msw-winterthur/uC_Board/README.md

# [uC_Board Wiki](https://github.com/msw-winterthur/uC_Board/wiki)

Du brauchst [Hilfe](https://github.com/msw-winterthur/uC_Board/wiki) oder weisst nicht [wo Anfangen](https://github.com/msw-winterthur/uC_Board/wiki)? Besuche unbedingt das [Wiki](https://github.com/msw-winterthur/uC_Board/wiki)!
