msw-winterthur/uC_Board/Dokumente/Herstellung/Eagle Fusion Tipps und Tricks.docx

- MOVE Teilenummer (MOVE R10 oder move r10)
- Gruppe in Schema Markieren → Wird auch auf Board markiert → Ganze Gruppe zusammen verschieben
- Am Raster Ausrichten: Ändern-Untermenü öffnen → Ausrichten wählen → Fadenkreuzsymbol wählen
