msw-winterthur/uC_Board/Dokumente/Herstellung/Layout-Hinweise.pdf

## uC-Board

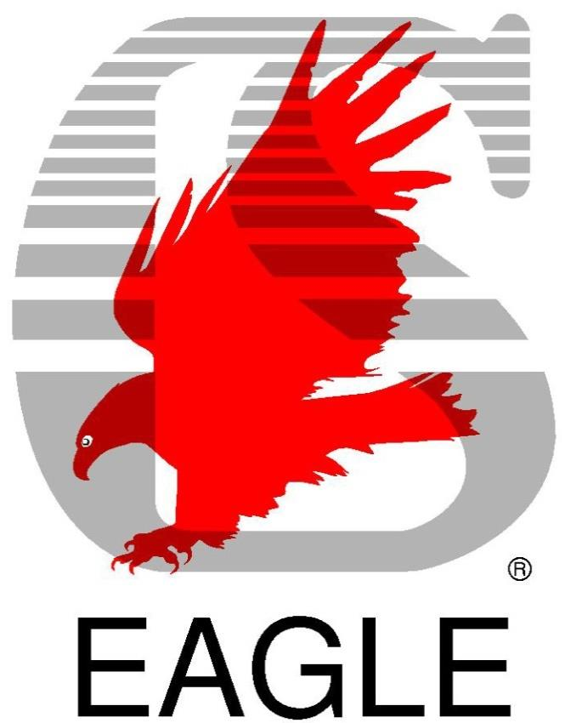
[picture p1: figure]
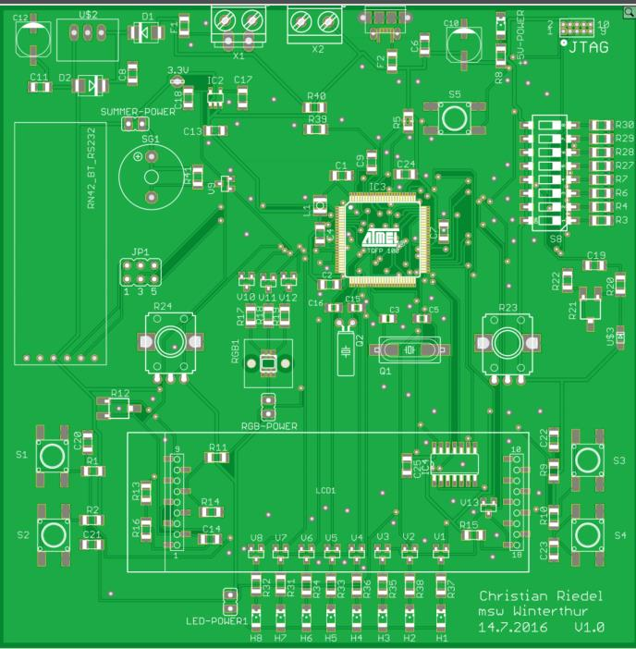
[picture p2: figure]

Layout-Hinweise.docx | Riedel/Trüb | Seite 1

# Layout-Hinweise zum uC-Board

### Inhaltsverzeichnis

### 1. Netzklassen

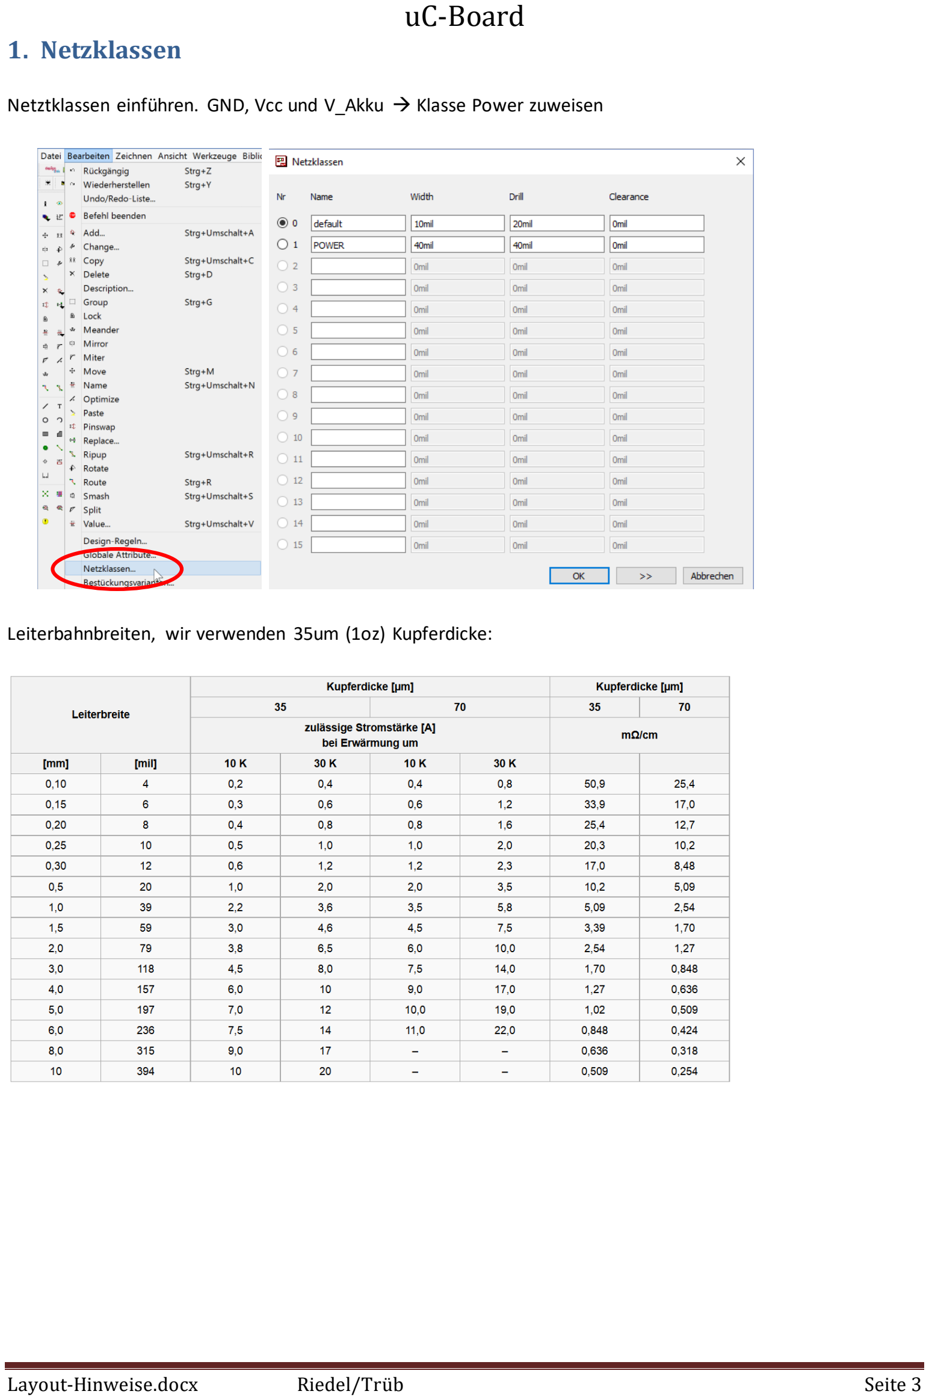
[picture p3: page 3]

Netztklassen einführen. GND, Vcc und V_Akku → Klasse Power zuweisen

Leiterbahnbreiten, wir verwenden 35um (1oz) Kupferdicke:

### 2. Raster

Für ein präzises Platzieren lohnt es sich, ein feines Raster einzustellen.

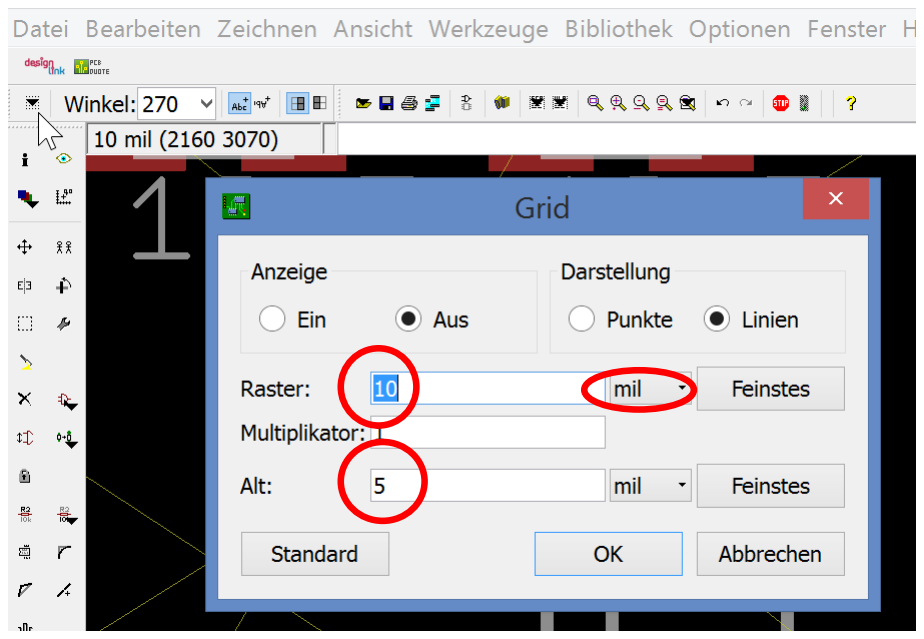
[picture p4: figure]

### 3. Design Rules

DRC Einstellungen vornehmen:

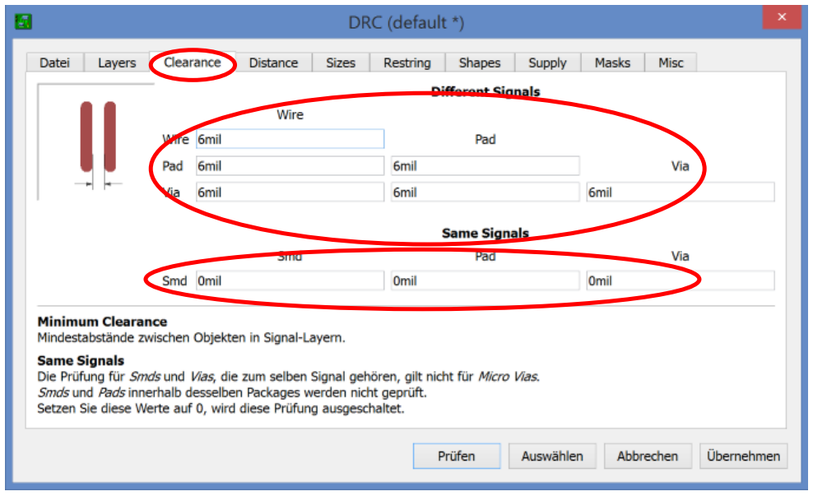
[picture p5: figure]
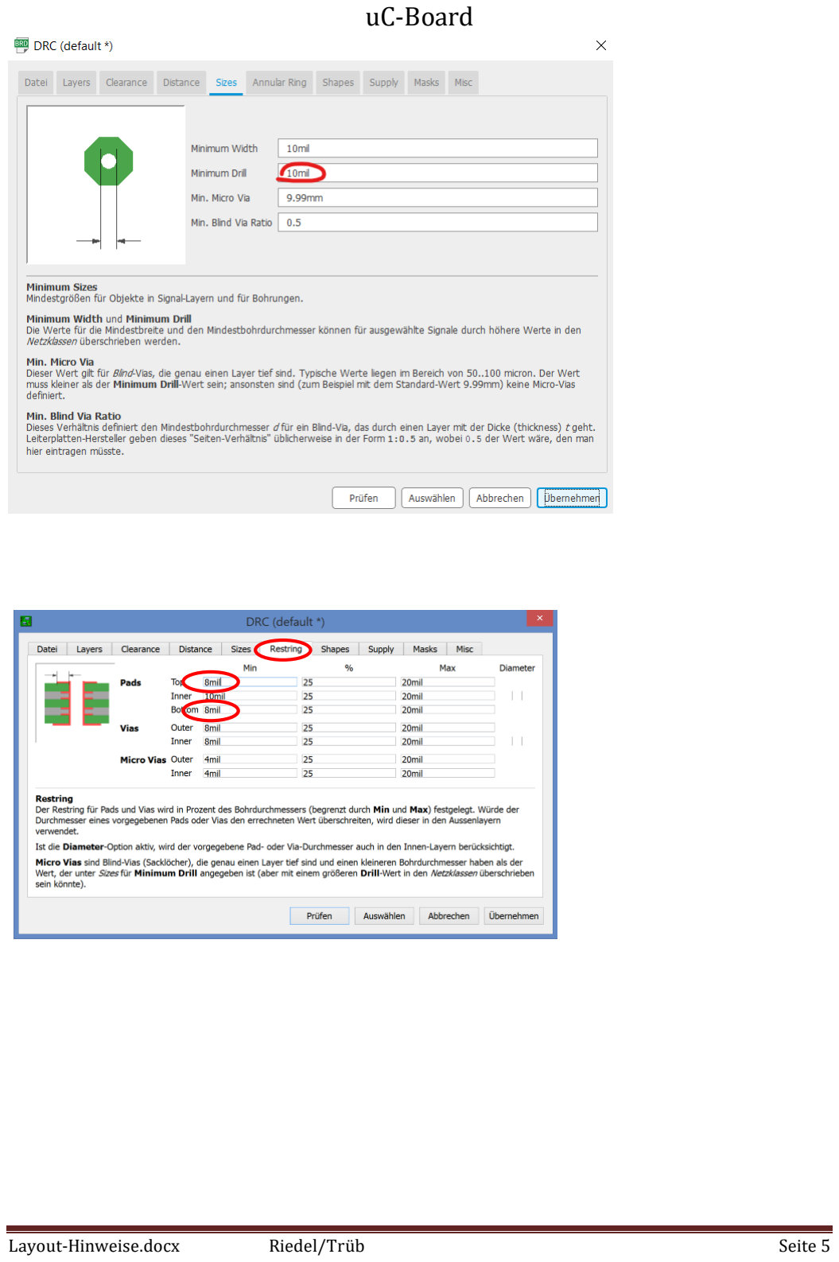
[picture p6: page 5]

### 4. Gruppieren

Platziere die Bauteile, so dass die Luftlinien möglichst optimal, also kurz sind.

Bauteile die im Schema zusammen gehören, sollten auch beim Platzieren nahe zusammen bleiben. Beispiele:
- Gruppe Quarz und Kondensatoren
- 8xLED Port mit FET, R und LED
- 5V Spannungsversorgung mit Spannungsregker, C, R, Sicheerung und Dioden

Auf dem Board:

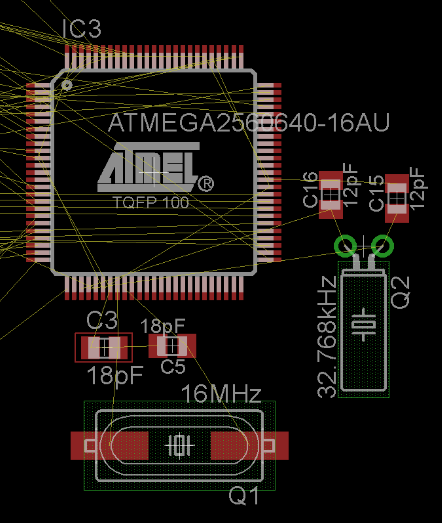
[picture p7: figure]

Quarz und Kondensatoren

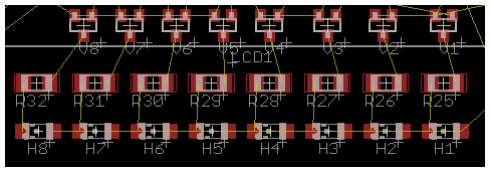
[picture p8: figure]

LED Port mit FET, R und LED

### 5. Stecker platzieren auf dem Board

ACHTUNG: | Phoenix Stecker | USB-C Stecker

Beide Stecker müssen über den Printrand hinaus platziert werden! Siehe Muster Prints BT_CAR_21.

JTAG-Stecker nahe am Rand platzieren und Pin1 links, damit sich Flachbandkabel gut einstecken lässt.

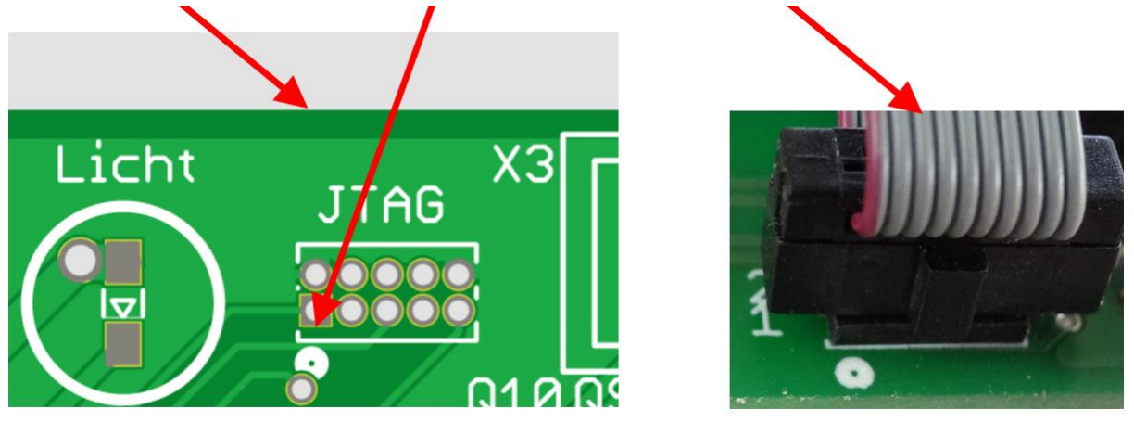
[picture p9: figure]

### 6. Bohrungen

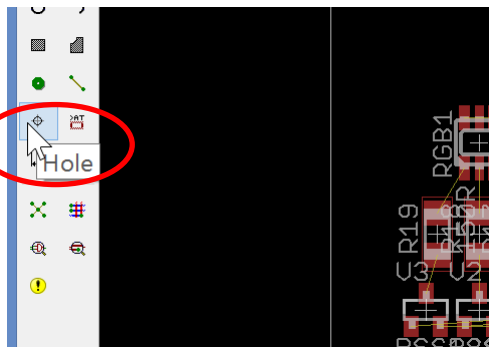
[picture p10: figure]
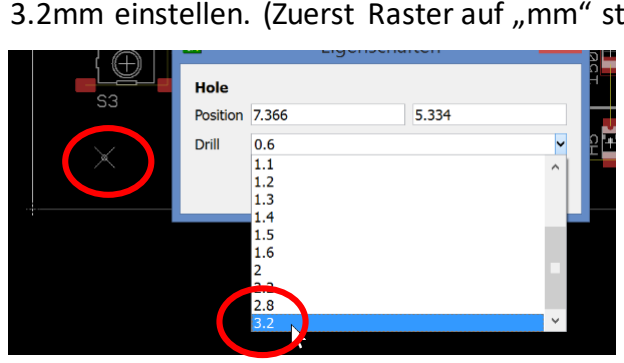
[picture p11: figure]

Bohrungen:
Befestigungslöcher platzieren Via „Info“ die Eigenschaft der Bohrung auf z.B. 3.2mm einstellen. (Zuerst Raster auf „mm“ stellen).

### 7. Autorouter

Nach dem Platzieren der Gruppen kann mit dem Autorouter überprüft werden, ob das Layouten möglich sein wird. Es sollten Werte von 95% oder grösser erreicht werden…

Mit der Einstellung Routing Grid wird eingestellt, wie fein der Autorouter arbeiten soll.

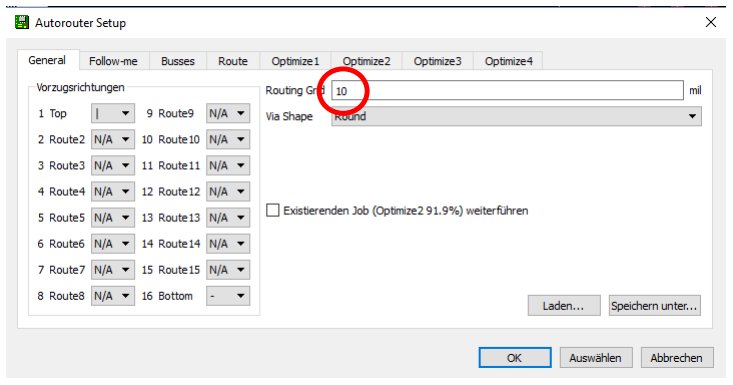
[picture p12: figure]

Je kleiner der Wert desto eher schafft er alles zu routen, braucht aber auch mehr Rechenzeit.

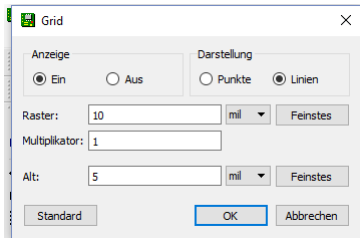
[picture p13: figure]
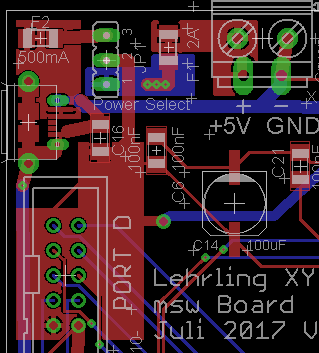
[picture p14: figure]

Zuerst die „dicken“ (mind. 30mil) VCC und GND Linien zu den Steckern ziehen. Eventuell Polygon zu Hilfe nehmen.
erst dann mit den dünnen Linien starten!

Raster beim selber Routen auf ein feines Mass einstellen.

Tipp: Auch hier kann mit Ctrl und Bauteil Auswahl das Element in den Raster „springen“.

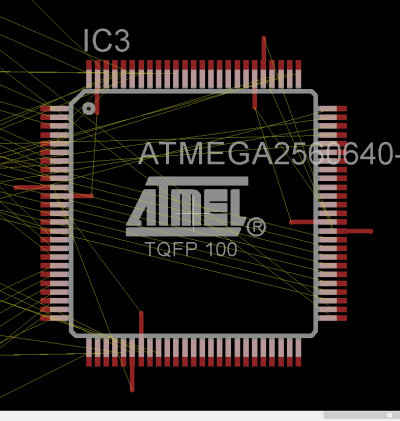
[picture p15: figure]

Vorbereitung Routen: GND, Vcc und Pins am Prozessor vorbereiten GND nach Innen (unter das Gehäuse) und Vcc nach Aussen (vom Gehäuse weg). So können die verschiedenen Netzklassen (unterschiedliche Leiterbahnbreiten), besser am Prozessor angeschlossen werden.

Beim selber Routen 10mil
Leiterbahnbreite einstellen!

Jetzt den Autorouter starten um die Platzierung zu überprüfen. Mit grosser Wahrscheinlichkeit wird 100% nicht erreicht. Autorouterwerte von ca. 95% gelten als guter Platzierungswert. Die Platzierung ist dann ok.

Selbst wenn der Autorouter eine 100% Lösung findet, ist das noch kein optimales Layout! Mehr dazu später.

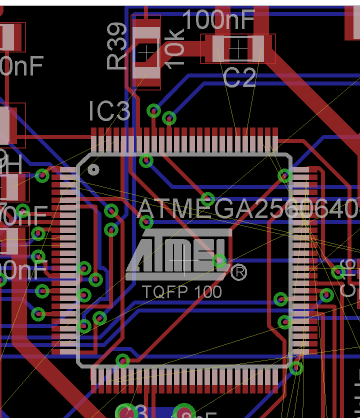
[picture p16: figure]
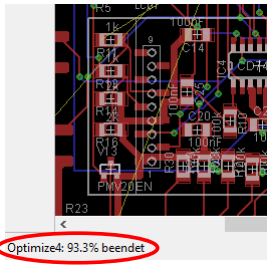
[picture p17: figure]

Gut zu erkennen, dass nicht alle Pins am Prozessor verbunden wurden
Die Verbindungen zu C2 konnten nicht realisiert werden, weil es GND und Vcc (Netzklasse POWER) sind. Diese Leitungen sind mit 40mil zu breit um am Prozessor angeschlossen zu werden. In solchen Fällen hilft das „hinausziehen“ dieser Pins.

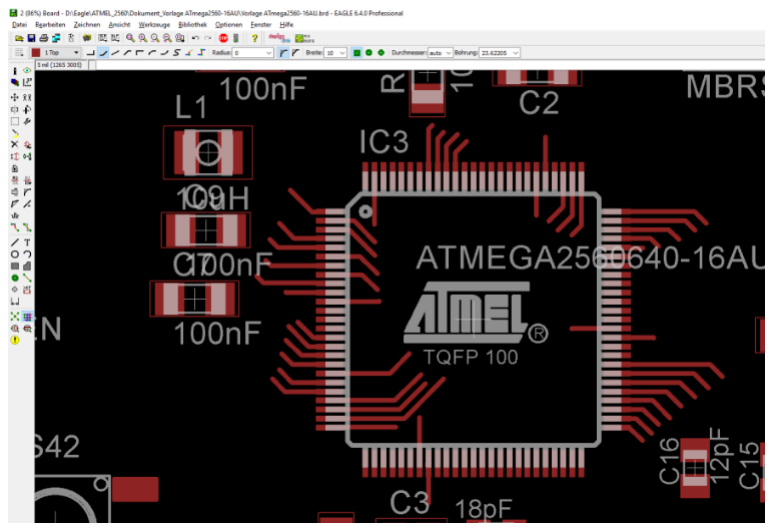
[picture p18: figure]

Mit Ripup Gruppe alle Leiterbahnen wieder löschen. Nun die „schwierigen“ Prozessorpins noch etwas verlängern. So hat der Autorouter mehr Möglichkeiten.

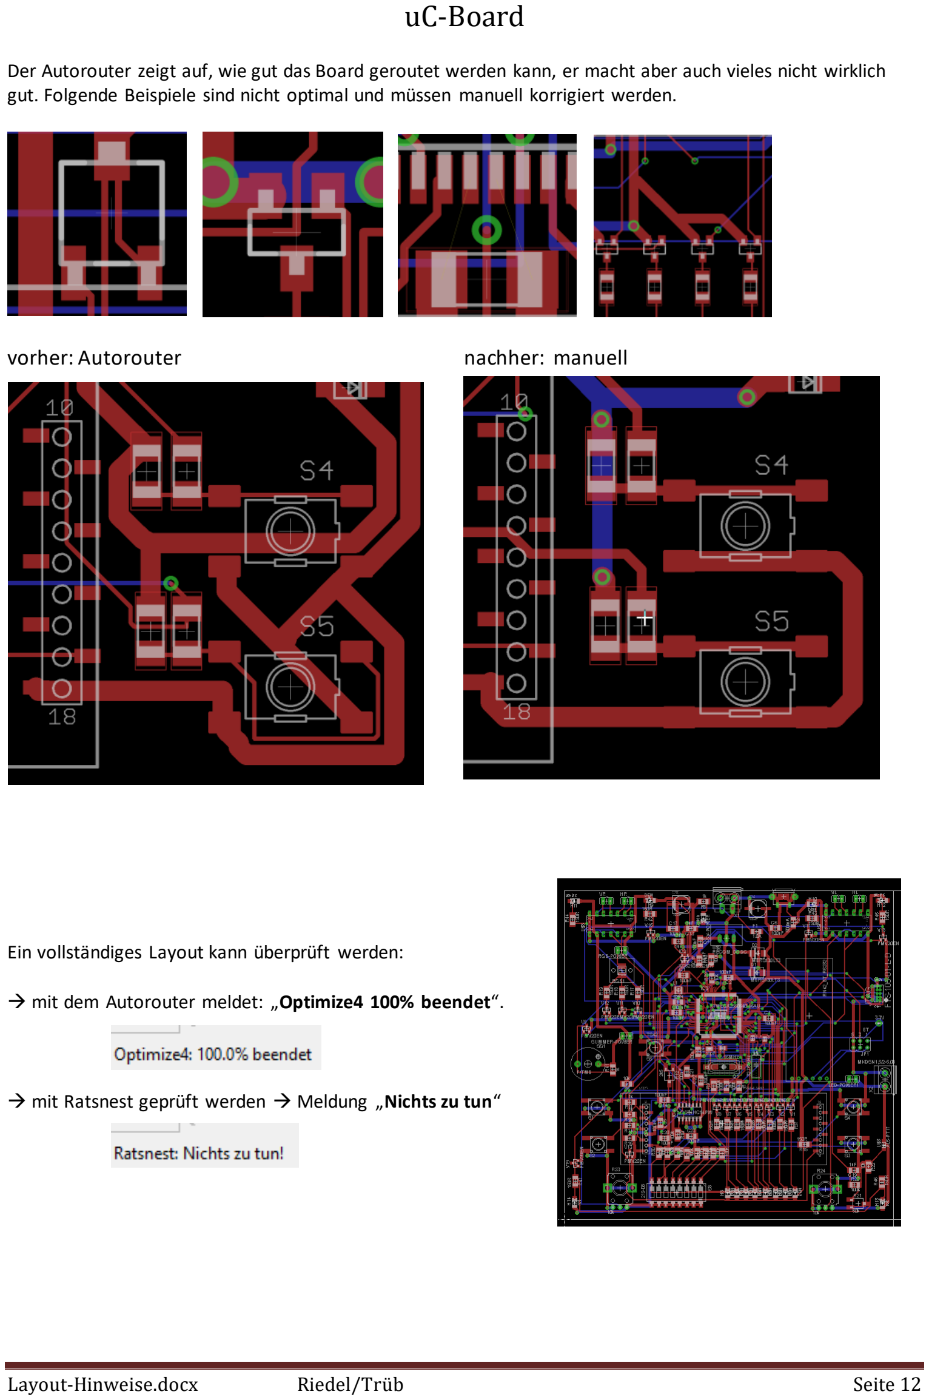
[picture p19: page 12]

Der Autorouter zeigt auf, wie gut das Board geroutet werden kann, er macht aber auch vieles nicht wirklich gut. Folgende Beispiele sind nicht optimal und müssen manuell korrigiert werden.

vorher: Autorouter | nachher: manuell

Ein vollständiges Layout kann überprüft werden:

→ mit dem Autorouter meldet: „Optimize4 100% beendet“.

→ mit Ratsnest geprüft werden → Meldung „Nichts zu tun“

### 8. Polygone

Das sollte jetzt so aussehen:

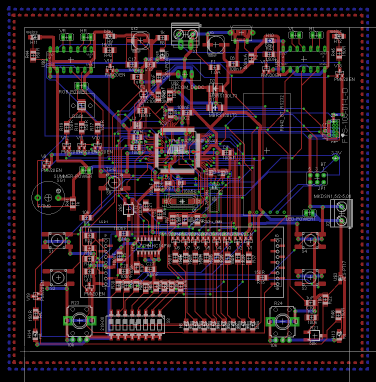
[picture p20: figure]

Ratsnest anklicken → Flächen werden erzeugt.

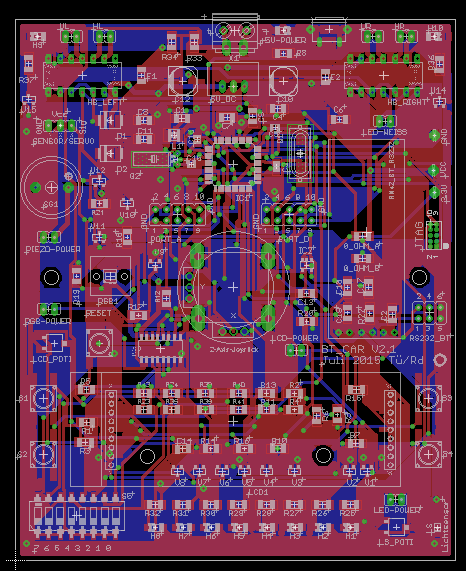
[picture p21: figure]

WICHTIG: Jetzt nochmals mit Ratsnest prüfen! Eventuell werden jetzt nicht mehr 100% erreicht! Die beiden Polygone sind dann in einzelne „Inseln“ zerfallen.

Lösung: GND Flächen auf Top- und Bottomlayer mit Vias verbinden, dann können wieder 100% erreicht werden. Am besten ein Via kopieren und auf den Namen GND ändern. Vias in die „Inselflächen“ setzen.

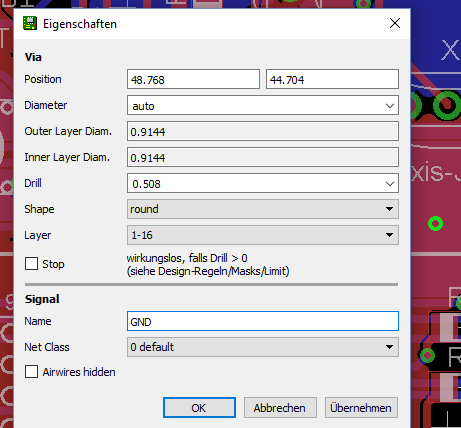
[picture p22: figure]

Mit Ratsnest nochmals alle Verbindungen prüfen! Bis 100% erreicht sind.

Jetzt zwei GND Polygone zeichnen Top-Layer und Bottom-Layer. Breite 40mil einstellen, resp. Breite die in der Netzklasse definiert ist.

### 9. Design Rule Check, DRC (Layout prüfen)

Weitere Vorbereitungen:
Layer tStop und bStop ausschalten, sonst gibt’s solche Fehler:

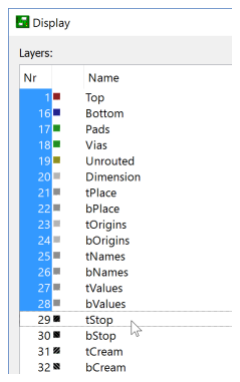
[picture p23: figure]
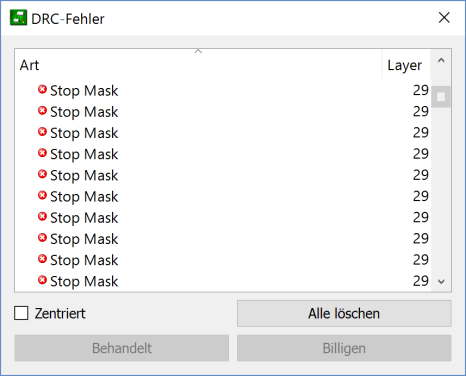
[picture p24: figure]

Netzklasse POWER wieder auf kleinste gezeichnete Grössse stellen Width = 10mil und Drill = 20mil, sonst gibt’s solche Fehler:

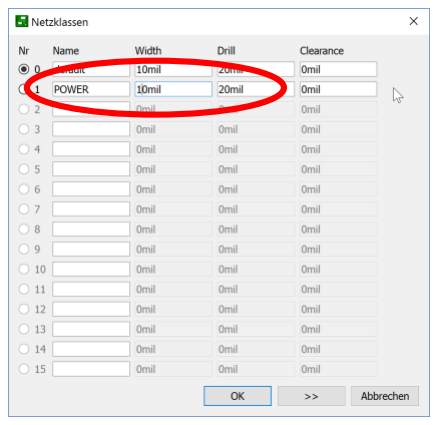
[picture p25: figure]
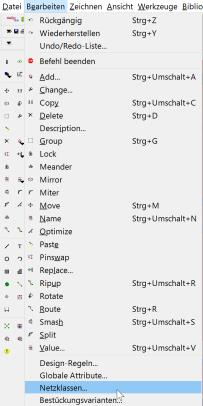
[picture p26: figure]
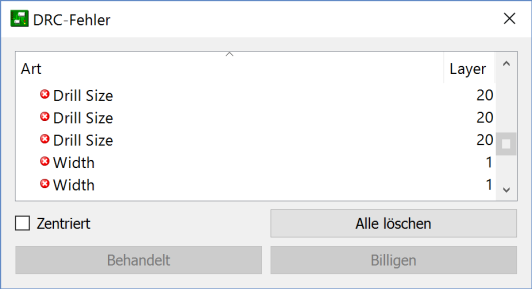
[picture p27: figure]

DRC ausführen … „Prüfen“ drücken

Allfällige Fehler beheben.

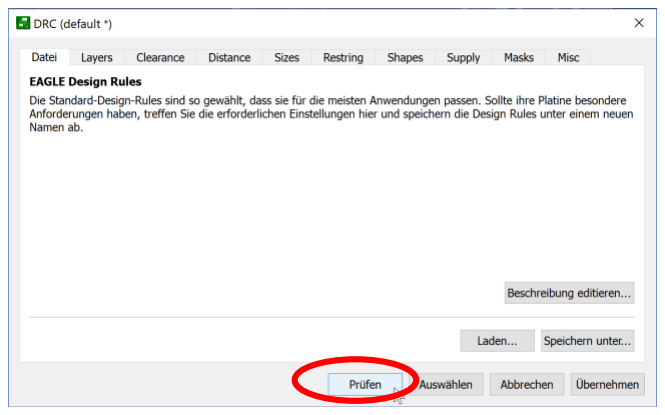
[picture p28: figure]

1. Doppelklick auf Fehlerzeile der Fehlerliste und der entsprechende Fehler wird Weiss eingerahmt. Hier ist der Abstand zwischen Durchkontaktierung und Leiterbahn zu klein.
2. Durchkontaktierung nach links verschieben.
3. DRC erneut ausführen.

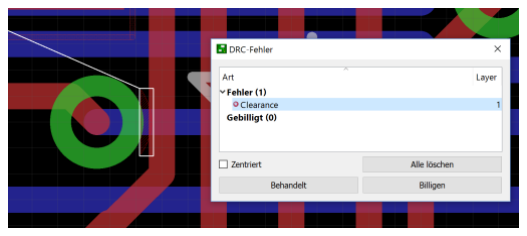
[picture p29: figure]
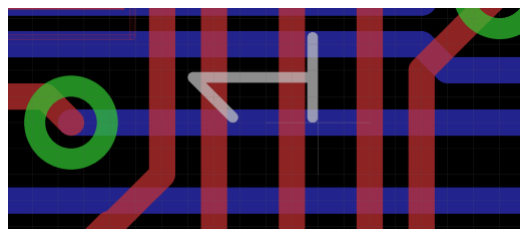
[picture p30: figure]

vorher | nachher

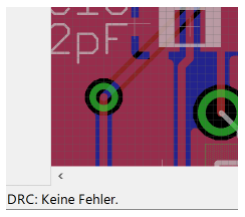
[picture p31: figure]

Wenn alle Fehler behoben sind, erscheint unten links folgende Erfolgsmeldung.

### 10. Siebdruck für Beschriftungen

Bitte folgendes beachten

tStop einbenden.

- Weil alle Widerstände den gleichen Wert 150R haben muss nicht jeder angeschrieben werden. → Einen stehen lassen, die anderen löschen.

Das gleiche gilt auch für die Transistoren PMV20EN

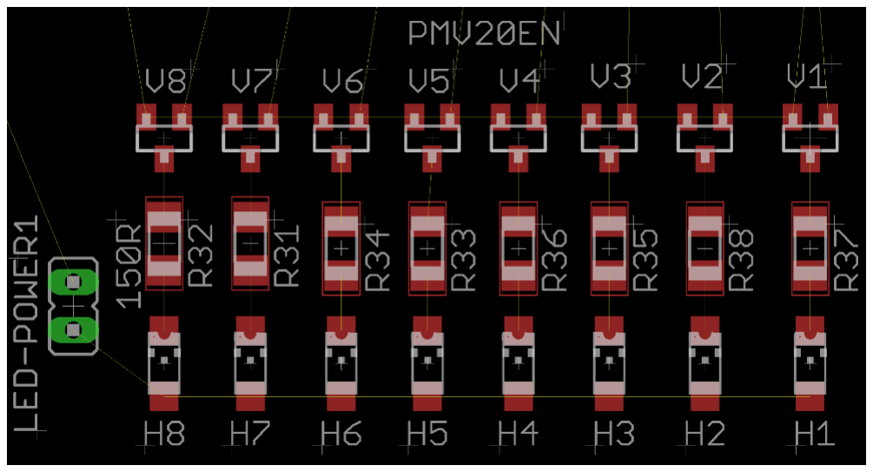
[picture p32: figure]
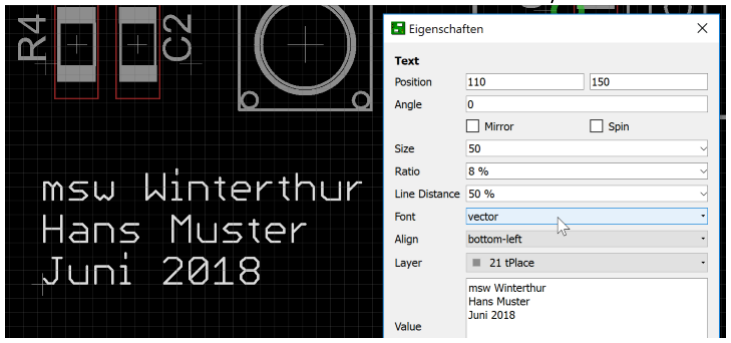
[picture p33: figure]

Mit Text den Namen auf das Board setzen. Text muss auf Layer 25 tNames sein! Schriftgrösse 70-100mil.

Vektorschrift einstellen!
