msw-winterthur/uC_Board/Dokumente/Herstellung/Bestückungs-Hinweise.pdf

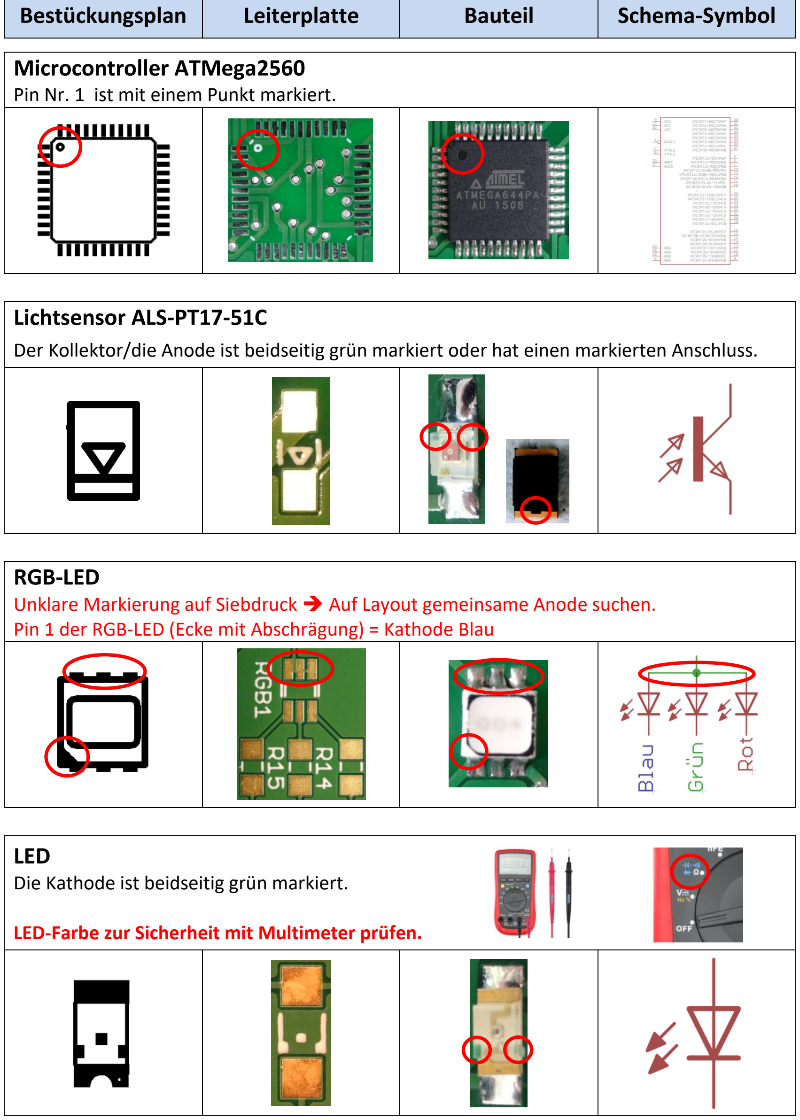
[picture p34: figure]
Bestückungsplan; Leiterplatte; Bauteil; Schema-Symbol; Microcontroller ATMega2560 Pin Nr. 1 ist mit einem Punkt markiert.; Lichtsensor ALS-PT17-51C; RGB-LED; LED

Copyright © by MSW Ch. Riedel | Bestückungs-Hinweise.docx | 10.09.2021 | Seite 1 von 2

## Bestückungshinweise: ATMega2560- Board

Der Kollektor/die Anode ist beidseitig grün markiert oder hat einen markierten Anschluss.

Unklare Markierung auf Siebdruck ➔ Auf Layout gemeinsame Anode suchen. Pin 1 der RGB-LED (Ecke mit Abschrägung) = Kathode Blau

Die Kathode ist beidseitig grün markiert.

LED-Farbe zur Sicherheit mit Multimeter prüfen.

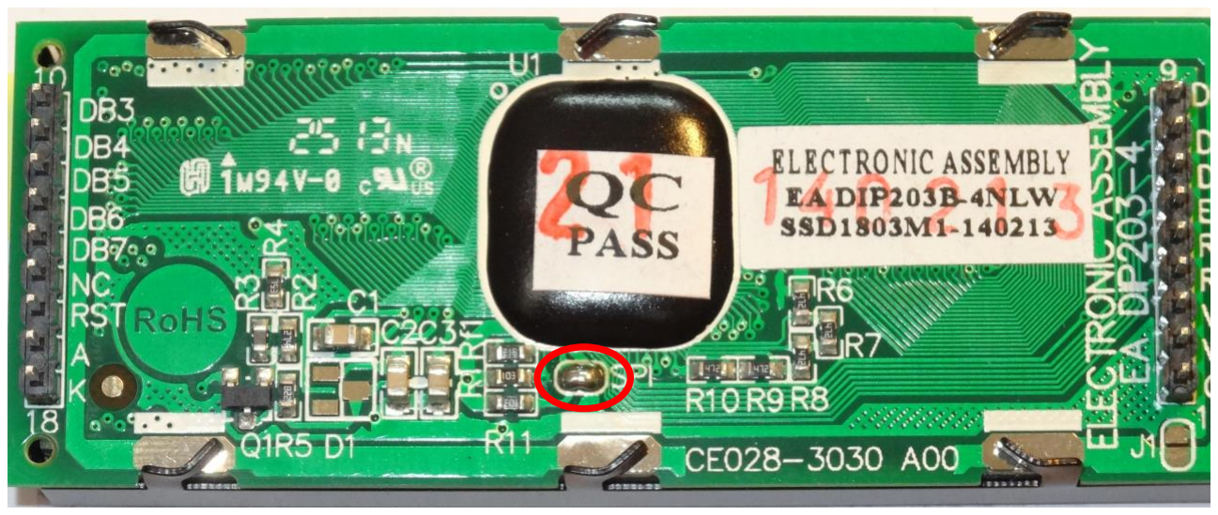
[picture p35: figure]

Copyright © by MSW Ch. Riedel | Bestückungs-Hinweise.docx | 10.09.2021 | Seite 2 von 2

Diode (Schottky)
Die Kathode ist mit einem Strich markiert.

Elektrolyt-Kondensator polarisiert
Minus ist mit einem schwarzen Strich markiert.

Stiftleiste für Flachbandkabel
Aussparung im Gehäuse beachten.

Buchsenleiste für JTAG
Aussparung im Gehäuse beachten, Aussparung befindet sich auf der Seite wo auch Pin1 ist.

Beim LCD muss auf der Rückseite noch eine Verbindungsbrücke (SPI) gelötet werden. Siehe rote Markierung.
