msw-winterthur/uC_Board/Dokumente/Herstellung/uC-Board Fuses.docx

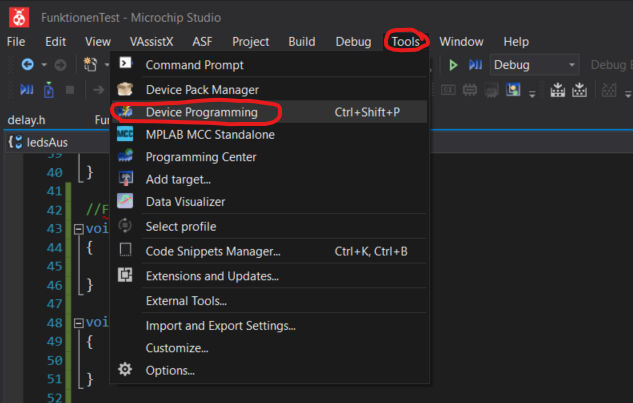
[picture p36: figure]
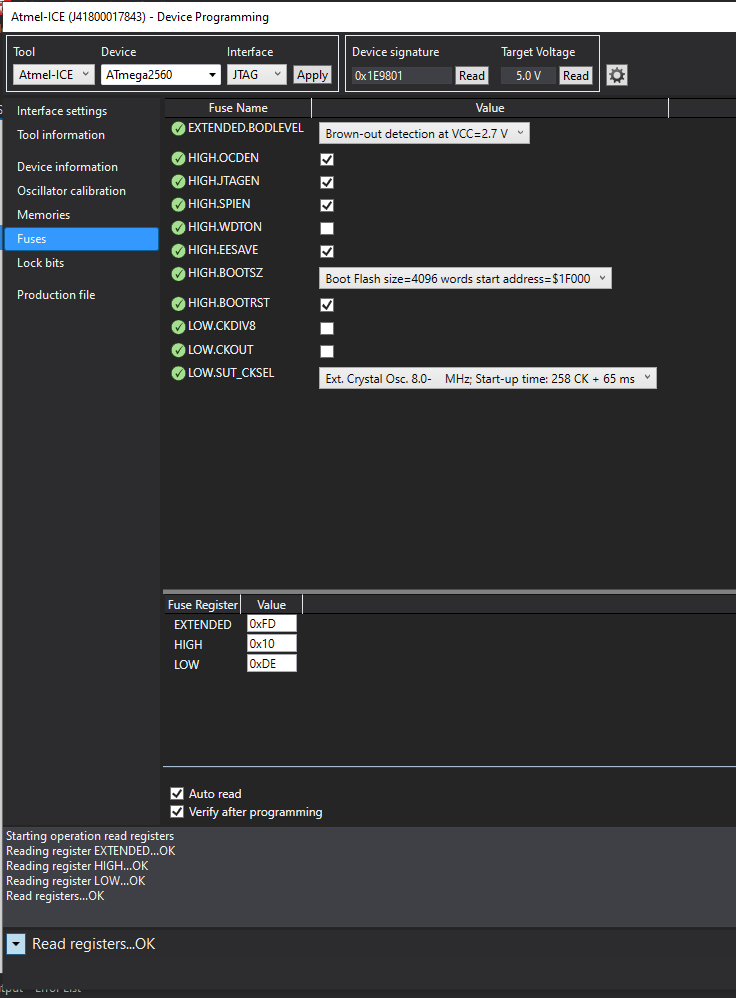
[picture p37: figure]
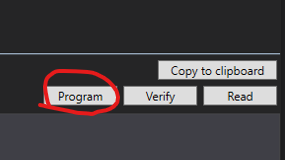
[picture p38: figure]
