msw-winterthur/uC_Board/Dokumente/Herstellung/Atmega2560 Fuses.png

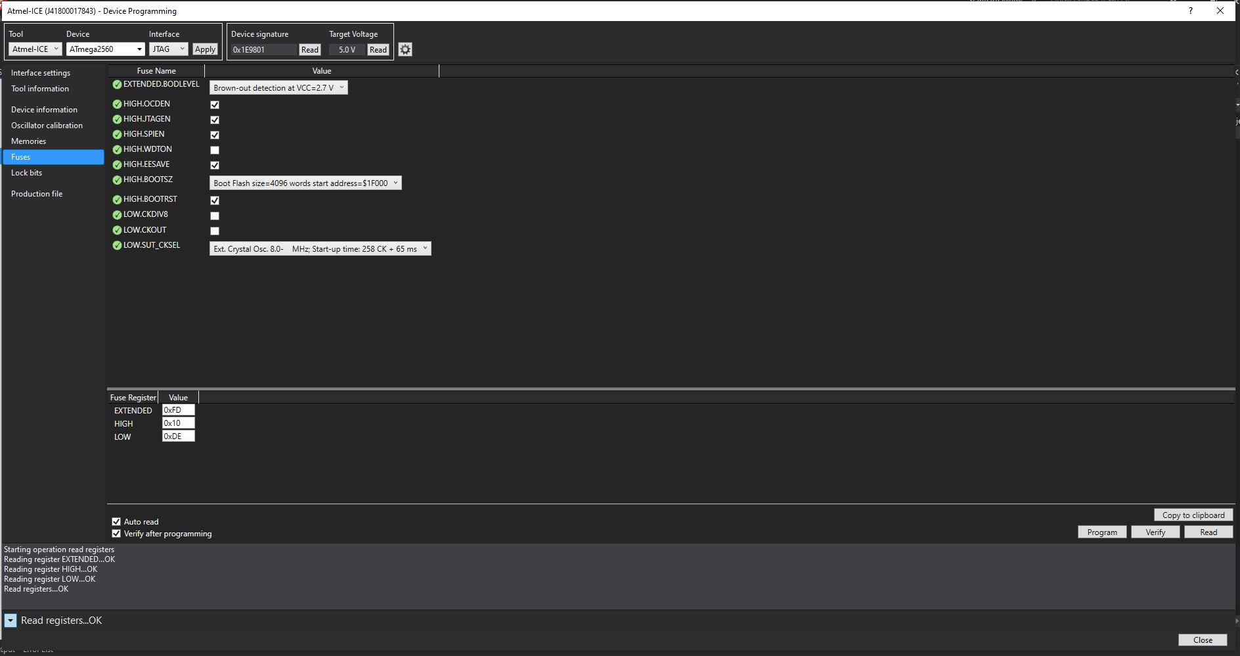
Dokumente/Herstellung/Atmega2560 Fuses.png
