msw-winterthur/uC_Board/BOM/Stückliste uC_Board.xlsx

Sheet: Stückliste
Projekt: uc-Board |  |  |  | Baugruppe: A |  | Dok-Nr.: 260717.444.2.A
Erstellt: AP, 17.07.2026 |  |  |  | Geändert: - |  | Geprüft: DD, 17.07.2026
Pos. | Referenz | Anz. | Bezeichnung | Typ | Footprint | Marking | Lieferant | Bestellnummer | Link | Bestand 17.7.26 | benötigt für 25 | Bestellen: | Bestellen:
1 |  | 1 | USB-C Kabel | Red, 1m |  |  | AliExpress |  | https://www.aliexpress.com/item/33002369577.html?spm=a2g0o.cart.0.0.38133c002f24TT&mp=1 | 10 | 25 | 15 | 15
2 | J1 | 1 | USB-C Buchse | 10 x USB-C, 6Pin |  |  | AliExpress |  | https://www.aliexpress.com/item/4000857925361.html | 195 | 25 | -170
3 | J2 | 1 | Joystick | Yellow (new) version |  |  | AliExpress |  | https://www.aliexpress.com/item/32641145656.html?spm=a2g0s.9042311.0.0.1a2c4c4dHblPEt | 89 | 25 | -64
4 | S5-S12 | 8 | Schalter | 10 x 5mm Miniature |  |  | AliExpress |  | https://www.aliexpress.com/item/1887673102.html?spm=a2g0o.cart.0.0.38133c002f24TT&mp=1 | 200 | 200 | 0
5 |  | 0 | Netzteil USB-C, 5V2A | ‎WR9MA2000USBCFMEDR6B‎ |  |  | digikey | ‎1939-2010-ND‎ | ‎1939-2010-ND‎ (https://www.digikey.ch/de/products/detail/globtek-inc/WR9MA2000USBCFMEDR6B/10187592) |  | 0 | 0
6 | IC2 | 1 | Mikrocontroller | ATMEGA2560-16AU | TQFP-100 |  | digikey | ATMEGA2560-16AU-ND |  | 72 | 25 | -47
7 | J3 | 1 | J-Tag-Buchse | Header VERT 10POS 1.27MM |  |  | digikey | 1175-1627-ND | https://www.digikey.ch/product-detail/de/cnc-tech/3220-10-0100-00/1175-1627-ND/3883661?cur=CHF&lang=de | 85 | 25 | -60
8 |  | 2 | Jtag stecker | CONN SOCKET 10POS IDC GOLD |  |  | digikey | 3230-10-0102-00 | https://www.digikey.ch/product-detail/de/3230-10-0102-00/3230-10-0102-00-ND/3883464/?itemSeq=343224426 | 220 | 50 | -170
9 |  | 1 | Jtag Kabel ca 10 cm | FLAT RBN CBL GRAY 10 COND 100' |  |  | digikey | CN211GR-100-ND | https://www.digikey.ch/products/de?keywords=cn211gr-100 | 25 | 25 | 0
10 |  | 1 | Linieal Footprints… | PCB-RULER-ND |  |  | digikey |  |  | 25 | 25 | 0
11 |  | 4 | Gummifuss transparent VPE20 | 40er Packung | 9,5x3,8mm |  | Distrelec | 300-97-569 |  | 480 | 100 | -380
12 |  | 1 | Micro-USB für Jtag | RND 765-00054 - USB-A Micro-B |  |  | Distrelec | 301-25-772 | https://www.distrelec.ch/de/usb-anschluss-auf-usb-micro-anschlusskabel-900mm-schwarz-rnd-connect-rnd-765-00054/p/30125772 | 25 | 25 | 0
13 |  | 1 | LED Diffusor | Abdeckung RGB LED |  |  | Farnell | 1215771 |  | 12 | 25 | 13 | 22
14 | R13 | 1 | Potentiometer | 3314G-1-252E / 2k5 | 3314G |  | Farnell | 2328470 |  | 160 | 25 | -135
15 |  | 0 | Anschlussblock Phönix | 2Pol | 3.81mm |  | Farnell | 3704725 |  |  | 0 | 0
16 |  | 0 | Schraub-Steckklemme Phönix | 2Pol | 3.81mm |  | Farnell | 3704907 |  |  | 0 | 0
17 | D16 | 1 | LED | RGB | PLCC6 |  | Farnell | LEDCLX6E-FKC-CH1M1D1BB7C3D3 |  | 70 | 25 | -45
18 | S1-S4, S13 | 5 | Taster | FSM4JSMA | 5mm |  | Farnell | 3801305 |  | 390 | 125 | -265
19 |  | 1 | Programmer | Atmel-Ice-Pcba | none |  | Farnell | 2407171 | https://ch.farnell.com/microchip/atatmel-ice-pcba/debugger-atmel-arm-avr-pcba-kit/dp/2407171 | 25 | 25 | 0
20 | IC6 | 1 | Spannungsregler 3.3V | XC6220B331MR-G | SOT-25 |  | Mouser | 865-XC6220B331MR-G |  | 105 | 25 | -80
21 | IC1 | 1 | Schmitt_Tirgger | Logic-IC SO-14, 74HC14D, NXP | SO-14 |  | Mouser | 771-74HC14D-Q100 |  | 52 | 25 | -27
22 | IC5 | 1 | 74HC138 3 to 8 Decoder | Texas | TSSOP-16 |  | Mouser | 771-74HC138D-Q100 |  | 52 | 25 | -27
23 | L1 | 1 | Induktivität | 10uH | 1206 |  | Mouser | 815-AIML-1206-100KT |  | 94 | 25 | -69
24 | Q1 | 1 | Quarz | 16MHz | HC49 |  | Mouser | 695-HCM49-16MABKUT |  | 108 | 25 | -83
25 | U2 | 1 | Lichtsensor | Ambient Light Sensors PHOTO TRANS.PCB-SMD F.DAYLIGHT 550NM-E4 | 0805 |  | Mouser | 78-TEMT6202FX01 |  | 120 | 25 | -95
26 | X3 | 1 | 2x7 Stiftwanne 2514 | würth | 2,54mm |  | Mouser | 710-61201421621 |  | 90 | 25 | -65
27 |  | 1 | Jumper | Jumper | 2.54mm |  | Mouser | 571-1-881545-4 |  | 256 | 25 | -231
28 | D17 | 1 | LED | Grün | 1206 |  | Mouser | 604-APL3015CGCK-F01 |  | 80 | 25 | -55
29 | R27,R41 | 2 | Potentiometer | 50k |  |  | Mouser | 81-PVG3G503C01R00 |  | 195 | 50 | -145
30 | Q2 | 1 | Quarz | 32.768kHz | 3.2x8.3mm |  | Mouser | 815-AB38T-32.768KHZ |  | 128 | 25 | -103
31 | U1 | 1 | Temperatursensor MCP9701-E/TO | TO-92 | 1,27mm |  | Mouser | 579-MCP9701-E/TO |  | 100 | 25 | -75
32 | F1, F2 | 2 | Sicherung | ERB-RG2R00V | 1206 |  | Mouser | 667-ERB-RG2R00V |  | 110 | 50 | -60
33 | LCD1, LCD1B | 2 | 9P Header für LCD Display | 1x9 Pin SMD | 2mm |  | Mouser | 200-SMM10902SSKTR |  | 190 | 50 | -140
34 | X1, X4 | 3 | 2x5 Stiftwanne 2510 | 3M | 2,54mm |  | Mouser | 517-30310-6002 |  | 240 | 75 | -165
35 | R1, R6 | 2 | Potentiometer | 10kOhm | PTV09A |  | Mouser | 652-PTV09A-4020UB103 |  | 164 | 50 | -114
36 | R10, R28 | 2 | Widerstand | 10kΩ | 1206 |  | Mouser | 71-CRCW120610K0FKEB |  | 400 | 50 | -350
37 | R15, R16 | 2 | Widerstand | 2kΩ | 1206 |  | Mouser | 708-RMCF1206FG2K00 (https://www.mouser.ch/ProductDetail/708-RMCF1206FG2K00) |  | 300 | 50 | -250
38 | C17, C18 | 2 | Keramikkondensator | 12pF 50V | 0805 |  | Mouser | 77-VJ0805A120GXAPBC |  | 130 | 50 | -80
39 | C8, C9 | 2 | Keramikkondensator | 18pF 25V | 0805 |  | Mouser | 77-VJ0805A180GXXCBC |  | 86 | 50 | -36
40 | U3, U4 | 2 | Hallsensor SS39E | Honeywell | SOT-23 |  | Mouser | 785-SS39ET |  | 72 | 50 | -22
41 | C14, C24, C25 | 3 | Elektrolytkondensator | 100uF 16V | 6.3 x 5.4 |  | Mouser | 710-865230245004 |  | 270 | 75 | -195
42 | R11, R12, R14 | 3 | Widerstand | 1kΩ | 1206 |  | Mouser | 71-CRCW12061K00FKEB |  | 390 | 75 | -315
43 | C19, C20, C22 | 3 | Keramikkondensator | 1uF 50V | 1206 |  | Mouser | 187-CL31B105KOFNNNE |  | 1700 | 75 | -1625
44 | JP1-JP3 | 4 | Stiftleiste 3pin | 1x36 Breakaway | 2.54mm |  | Mouser | 538-22-28-4360 |  | 1300 | 100 | -1200
45 | V1-V21 | 21 | FET N-Kanal | 20 V, 0.8A, PMV450ENEAR | SOT-23 |  | Mouser | 771-PMV450ENEAR |  | 2600 | 525 | -2075
46 | Q3-Q10 | 8 | FET P-Kanal | 20V, 5.6A, 27mΩ, PMV27UPER | SOT-23 |  | Mouser | 771-PMV27UPER |  | 650 | 200 | -450
47 | R3, R4, R8, R9, R26, R45 | 6 | Widerstand | 100kΩ | 1206 |  | Mouser | 71-CRCW1206100KFKEB |  | 960 | 150 | -810
48 | C1-C7, C10-C13, C15, C16, C21, C23, C26 | 15 | Keramikkondensator | 100nF 50V | 1206 |  | Mouser | 80-C1206C104K5R |  | 1000 | 375 | -625
49 | D0-D15 | 16 | LED | Blau | 1206 |  | Mouser | 604-APT3216QBC/D |  | 1390 | 400 | -990
50 | R2, R5, R7, R17-R25, R29-R36 | 20 | Widerstand | 150Ω | 1206 |  | Mouser | 708-RMCF1206JT150R |  | 1600 | 500 | -1100
51 |  | 1 | Widerstand | 4.7Ohm | 0805 |  | Mouser | 755-ESR10EZPJ4R7 | https://www.mouser.ch/ProductDetail/ROHM-Semiconductor/ESR10EZPJ4R7 | 210 | 25 | -185
52 | D20, D21 | 2 | Diode | shotky | SOD-123-2 |  | Mouser | 78-SD103CW-HE3_A-08 | https://www.mouser.ch/ProductDetail/Vishay/SD103CW-HE3_A-08?qs=Imq1NPwxi75eP9XDj9IIZg%3D%3D | 170 | 50 | -120
53 | C27 | 1 | Kondensator | 22nF | 0805 |  | Mouser | 603-CC805JRX7R8BB223 | https://www.mouser.ch/ProductDetail/YAGEO/CC0805JRX7R8BB223?qs=57cj7OiSijk%252BueqZYCThQQ%3D%3D | 70 | 25 | -45
54 | R39, R40 | 2 | Widerstand | 470R | 0805 |  | Mouser | 652-CR0805JW-471ELF | https://www.mouser.ch/ProductDetail/Bourns/CR0805-JW-471ELF | 210 | 50 | -160
55 | R37, R38 | 2 | Widerstand | 5k1R | 0805 |  | Mouser | 755-SFR10EZPF5101 | https://www.mouser.ch/ProductDetail/ROHM-Semiconductor/SFR10EZPF5101?qs=PqoDHHvF6491bPJygeZFGw%3D%3D | 130 | 50 | -80
56 |  | 1 | LCD 4x40 Zeichen | EA DIP205G |  |  | Mouser | 790-EADIP205G-4NLED (https://www.mouser.ch/de/ProductDetail/Display-Visions/EA-DIP205G-4NLED?qs=63Lh8XYXgjvICE3qPeFzCA%3D%3D) | 790-EADIP205G-4NLED (https://www.mouser.ch/de/ProductDetail/Display-Visions/EA-DIP205G-4NLED?qs=63Lh8XYXgjvICE3qPeFzCA%3D%3D) | 8 | 25 | 17 | 17

Sheet: Hilfe
01_Erläuterungen zum Ausfüllen einer Stückliste.pdf (https://studmswch.sharepoint.com/:b:/s/MSW-EK/IQADzYVIL4Z6RYHM9LvFaS7cAaHDWcMps8wS34NvU4EJE2s?e=OZbZhI)
Dokumenten Nummerierung.docx (https://studmswch.sharepoint.com/:w:/s/MSW-EK/IQD9HyacXsA6R6I1vsnSvZADAQNl2sAuTtJ7mR4emLyg6MU?e=pOfi1L)

Sheet: ALT
Projekt: uc-Board |  |  |  | Baugruppe: A |  | Dok-Nr.: 260717.444.2.A
Erstellt: AP, 17.07.2026 |  |  |  | Geändert: - |  | Geprüft: DD, 17.07.2026
Pos. | Referenz | Anz. | Bezeichnung | Typ | Footprint | Marking | Lieferant | Bestellnummer | Link | Bestand 17.7.26 | benötigt für 25 | Bestellen: | Bestellen:
56 |  | 1 | LCD 4x40 Zeichen | EADIP203-4 |  |  | Reichelt | EA DIP203G-4 | https://www.reichelt.de/ch/de/lcd-dip-modul-supertwist-4x20-zeichen-gb-gn-ea-dip203g-4-p129611.html?nbc=1
