msw-winterthur/uC_Board/BOM/materialliste_microcontroller_board.xlsx

Sheet: Stückliste
Bemerkung | Pos | Bezug | Stk/Board | Bezeichnung | Typ/Wert | Gehäuse | Lieferant | Artikel-Nr | Link | Preis/Stk | Preis/Board | Stk für 60 | Preis für 60 | Bestand 04.09.2025 (Dario) | Bestellt | Erwarteter Überschuss | Erwarteter Überschuss %
 |  |  | 0.5 | USB-C Kabel | Red, 1m |  | AliExpress |  | https://www.aliexpress.com/item/33002369577.html?spm=a2g0o.cart.0.0.38133c002f24TT&mp=1 | 1.720 | 0.86 | 30 | 51.60 | 8 | 50 | 28 | 93.33333333%
 |  |  | 1 | USB-C Buchse | 10 x USB-C, 6Pin |  | AliExpress |  | https://www.aliexpress.com/item/4000857925361.html | 1.299 | 1.30 | 60 | 77.94 | 200 |  | 140 | 233.3333333%
 |  |  | 1 | Joystick | Yellow (new) version |  | AliExpress |  | https://www.aliexpress.com/item/32641145656.html?spm=a2g0s.9042311.0.0.1a2c4c4dHblPEt | 1.760 | 1.76 | 60 | 105.60 | 10 | 100 | 50 | 83.33333333%
 |  |  | 8 | Schalter | 10 x 5mm Miniature |  | AliExpress |  | https://www.aliexpress.com/item/1887673102.html?spm=a2g0o.cart.0.0.38133c002f24TT&mp=1 | 0.648 | 5.18 | 480 | 311.04 | 250 | 500 | 270 | 56.25%
 |  |  | 0 | Netzteil USB-C, 5V2A | ‎WR9MA2000USBCFMEDR6B‎ |  | digikey | ‎1939-2010-ND‎ | ‎1939-2010-ND‎ (https://www.digikey.ch/de/products/detail/globtek-inc/WR9MA2000USBCFMEDR6B/10187592) | 9.000 |  | 0 |  |  |  | 0 | #DIV/0!
 |  |  | 1 | Mikrocontroller | ATMEGA2560-16AU | TQFP-100 | digikey | ATMEGA2560-16AU-ND |  | 16.570 | 16.57 | 60 | 994.20 | 4 | 100 | 44 | 73.33333333%
 |  |  | 1 | J-Tag-Buchse | Header VERT 10POS 1.27MM |  | digikey | 1175-1627-ND | https://www.digikey.ch/product-detail/de/cnc-tech/3220-10-0100-00/1175-1627-ND/3883661?cur=CHF&lang=de | 0.530 | 0.53 | 60 | 31.80 | 100 |  | 40 | 66.66666667%
 |  |  | 2 | Jtag stecker | CONN SOCKET 10POS IDC GOLD |  | digikey | 3230-10-0102-00 | https://www.digikey.ch/product-detail/de/3230-10-0102-00/3230-10-0102-00-ND/3883464/?itemSeq=343224426 | 0.690 | 1.38 | 120 | 82.80 | 40 | 250 | 170 | 141.6666667%
 |  |  | 1 | Jtag Kabel ca 10 cm | FLAT RBN CBL GRAY 10 COND 100' |  | digikey | CN211GR-100-ND | https://www.digikey.ch/products/de?keywords=cn211gr-100 | 0.107 | 0.11 | 60 | 6.43 | 100 |  | 40 | 66.66666667%
 |  |  | 0.5 | Linieal Footprints… | PCB-RULER-ND |  | digikey |  |  | 3.010 | 1.50 | 30 | 90.30 | 4 | 30 | 4 | 13.33333333%
 |  |  | 4 | Gummifuss transparent VPE20 | 40er Packung | 9,5x3,8mm | Distrelec | 300-97-569 |  | 0.105 | 0.42 | 240 | 25.20 | 100 | 400 | 260 | 108.3333333%
 |  |  | 0.5 | Micro-USB für Jtag | RND 765-00054 - USB-A Micro-B |  | Distrelec | 301-25-772 | https://www.distrelec.ch/de/usb-anschluss-auf-usb-micro-anschlusskabel-900mm-schwarz-rnd-connect-rnd-765-00054/p/30125772 | 1.240 | 0.62 | 30 | 37.20 | 2 | 50 | 22 | 73.33333333%
 |  |  | 1 | LED Diffusor | Abdeckung RGB LED |  | Farnell | 1215771 |  | 2.240 | 2.24 | 60 | 134.40 | 40 | 50 | 30 | 50%
 |  |  | 1 | Potentiometer | 3314G-1-252E / 2k5 | 3314G | Farnell | 2328470 |  | 0.934 | 0.93 | 60 | 56.04 | 10 | 100 | 50 | 83.33333333%
nicht bestücken |  |  | 0 | Anschlussblock Phönix | 2Pol | 3.81mm | Farnell | 3704725 |  | 0.702 |  | 0 |  |  |  | 0 | #DIV/0!
nicht bestücken |  |  | 0 | Schraub-Steckklemme Phönix | 2Pol | 3.81mm | Farnell | 3704907 |  | 2.600 |  | 0 |  |  |  | 0 | #DIV/0!
 |  |  | 1 | LED | RGB | PLCC6 | Farnell | LEDCLX6E-FKC-CH1M1D1BB7C3D3 |  | 0.364 | 0.36 | 60 | 21.84 | 40 | 50 | 30 | 50%
 |  |  | 5 | Taster | FSM4JSMA | 5mm | Farnell | 3801305 |  | 0.128 | 0.64 | 300 | 38.40 | 300 | 200 | 200 | 66.66666667%
 |  |  | 0.5 | Programmer | Atmel-Ice-Pcba | none | Farnell | 2407171 | https://ch.farnell.com/microchip/atatmel-ice-pcba/debugger-atmel-arm-avr-pcba-kit/dp/2407171 | 55.640 | 27.82 | 30 | 1669.20 | 4 | 30 | 4 | 13.33333333%
 |  |  | 1 | Spannungsregler 3.3V | XC6220B331MR-G | SOT-25 | Mouser | 865-XC6220B331MR-G |  | 0.782 | 0.78 | 60 | 46.92 | 100 |  | 40 | 66.66666667%
 |  |  | 1 | Schmitt_Tirgger | Logic-IC SO-14, 74HC14D, NXP | SO-14 | Mouser | 771-74HC14D-Q100 |  | 0.320 | 0.32 | 60 | 19.20 | 70 |  | 10 | 16.66666667%
 |  |  | 1 | 74HC138 3 to 8 Decoder | Texas | TSSOP-16 | Mouser | 771-74HC138D-Q100 |  | 0.455 | 0.46 | 60 | 27.30 | 70 |  | 10 | 16.66666667%
 |  |  | 1 | Induktivität | 10uH | 1206 | Mouser | 815-AIML-1206-100KT |  | 0.071 | 0.07 | 60 | 4.26 | 0 | 100 | 40 | 66.66666667%
 |  |  | 1 | Quarz | 16MHz | HC49 | Mouser | 695-HCM49-16MABKUT |  | 0.460 | 0.46 | 60 | 27.60 | 15 | 100 | 55 | 91.66666667%
 |  |  | 1 | Lichtsensor | Ambient Light Sensors PHOTO TRANS.PCB-SMD F.DAYLIGHT 550NM-E4 | 0805 | Mouser | 78-TEMT6202FX01 |  | 0.615 | 0.61 | 60 | 36.90 | 0 | 100 | 40 | 66.66666667%
 |  |  | 1 | 2x7 Stiftwanne 2514 | würth | 2,54mm | Mouser | 710-61201421621 |  | 0.900 | 0.90 | 60 | 54.00 | 50 | 50 | 40 | 66.66666667%
 |  |  | 1 | Jumper | Jumper | 2.54mm | Mouser | 571-1-881545-4 |  | 0.050 | 0.05 | 60 | 3.00 | 200 |  | 140 | 233.3333333%
 |  |  | 1 | LED | Grün | 1206 | Mouser | 604-APL3015CGCK-F01 |  | 0.130 | 0.13 | 60 | 7.80 | 0 | 100 | 40 | 66.66666667%
 |  |  | 2 | Potentiometer | 50k |  | Mouser | 81-PVG3G503C01R00 |  | 0.600 | 1.20 | 120 | 72.00 | 15 | 200 | 95 | 79.16666667%
 |  |  | 1 | Quarz | 32.768kHz | 3.2x8.3mm | Mouser | 815-AB38T-32.768KHZ |  | 0.156 | 0.16 | 60 | 9.36 | 15 | 100 | 55 | 91.66666667%
 |  |  | 1 | Temperatursensor MCP9701-E/TO | TO-92 | 1,27mm | Mouser | 579-MCP9701-E/TO |  | 0.749 | 0.75 | 60 | 44.94 | 64 | 50 | 54 | 90%
 |  |  | 2 | Sicherung | ERB-RG2R00V | 1206 | Mouser | 667-ERB-RG2R00V |  | 0.475 | 0.95 | 120 | 57.00 | 200 |  | 80 | 66.66666667%
 |  |  | 2 | 9P Header für LCD Display | 1x9 Pin SMD | 2mm | Mouser | 200-SMM10902SSKTR |  | 2.100 | 4.20 | 120 | 252.00 | 65 | 150 | 95 | 79.16666667%
 |  |  | 3 | 2x5 Stiftwanne 2510 | 3M | 2,54mm | Mouser | 517-30310-6002 |  | 0.619 | 1.86 | 180 | 111.42 | 380 |  | 200 | 111.1111111%
 |  |  | 2 | Potentiometer | 10kOhm | PTV09A | Mouser | 652-PTV09A-4020UB103 |  | 0.720 | 1.44 | 120 | 86.40 | 190 |  | 70 | 58.33333333%
 |  |  | 2 | Widerstand | 10kΩ | 1206 | Mouser | 71-CRCW120610K0FKEB |  | 0.027 | 0.05 | 120 | 3.24 | 0 | 200 | 80 | 66.66666667%
 |  |  | 2 | Widerstand | 2kΩ | 1206 | Mouser | 708-RMCF1206FG2K00 (https://www.mouser.ch/ProductDetail/708-RMCF1206FG2K00) |  | 0.031 | 0.06 | 120 | 3.72 | 200 |  | 80 | 66.66666667%
 |  |  | 2 | Keramikkondensator | 12pF 50V | 0805 | Mouser | 77-VJ0805A120GXAPBC |  | 0.015 | 0.03 | 120 | 1.80 | 40 | 150 | 70 | 58.33333333%
 |  |  | 2 | Keramikkondensator | 18pF 25V | 0805 | Mouser | 77-VJ0805A180GXXCBC |  | 0.029 | 0.06 | 120 | 3.48 | 150 |  | 30 | 25%
 |  |  | 2 | Hallsensor SS39E | Honeywell | SOT-23 | Mouser | 785-SS39ET |  | 1.210 | 2.42 | 120 | 145.20 | 120 | 50 | 50 | 41.66666667%
 |  |  | 3 | Elektrolytkondensator | 100uF 16V | 6.3 x 5.4 | Mouser | 710-865230245004 |  | 0.223 | 0.67 | 180 | 40.14 | 300 |  | 120 | 66.66666667%
 |  |  | 3 | Widerstand | 1kΩ | 1206 | Mouser | 71-CRCW12061K00FKEB |  | 0.010 | 0.03 | 180 | 1.80 | 250 |  | 70 | 38.88888889%
 |  |  | 3 | Keramikkondensator | 1uF 50V | 1206 | Mouser | 187-CL31B105KOFNNNE |  | 0.040 | 0.12 | 180 | 7.20 | 300 |  | 120 | 66.66666667%
 |  |  | 4 | Stiftleiste 3pin | 1x36 Breakaway | 2.54mm | Mouser | 538-22-28-4360 |  | 0.045 | 0.18 | 240 | 10.80 | 800 |  | 560 | 233.3333333%
 |  |  | 21 | FET N-Kanal 20 V, 0.8A, PMV450ENEAR | SOT23 | SOT-23 | Mouser | 771-PMV450ENEAR |  | 0.088 | 1.85 | 1260 | 110.88 | 1000 | 1000 | 740 | 58.73015873%
 |  |  | 8 | FET P-Kanal 20V, 5.6A, 27mΩ | PMV27UPER | SOT-23 | Mouser | 771-PMV27UPER |  | 0.138 | 1.10 | 480 | 66.24 | 100 | 500 | 120 | 25%
 |  |  | 6 | Widerstand | 100kΩ | 1206 | Mouser | 71-CRCW1206100KFKEB |  | 0.010 | 0.06 | 360 | 3.60 | 400 |  | 40 | 11.11111111%
 |  |  | 15 | Keramikkondensator | 100nF 50V | 1206 | Mouser | 80-C1206C104K5R |  | 0.017 | 0.26 | 900 | 15.30 | 200 | 1000 | 300 | 33.33333333%
 |  |  | 16 | LED | Blau | 1206 | Mouser | 604-APT3216QBC/D |  | 0.156 | 2.50 | 960 | 149.76 | 1000 | 500 | 540 | 56.25%
 |  |  | 20 | Widerstand | 150Ω | 1206 | Mouser | 708-RMCF1206JT150R |  | 0.011 | 0.22 | 1200 | 13.20 | 2000 |  | 800 | 66.66666667%
 |  |  | 1 | Widerstand | 4.7Ohm | 0805 | Mouser | 755-ESR10EZPJ4R7 | https://www.mouser.ch/ProductDetail/ROHM-Semiconductor/ESR10EZPJ4R7 | 0.026 | 0.03 | 60 | 1.56 | 50 | 100 | 90 | 150%
 |  |  | 2 | Diode | shotky | SOD-123-2 | Mouser | 78-SD103CW-HE3_A-08 | https://www.mouser.ch/ProductDetail/Vishay/SD103CW-HE3_A-08?qs=Imq1NPwxi75eP9XDj9IIZg%3D%3D | 0.241 | 0.48 | 120 | 28.92 | 60 | 150 | 90 | 75%
 |  |  | 1 | Kondensator | 22nF | 0805 | Mouser | 603-CC805JRX7R8BB223 | https://www.mouser.ch/ProductDetail/YAGEO/CC0805JRX7R8BB223?qs=57cj7OiSijk%252BueqZYCThQQ%3D%3D | 0.048 | 0.05 | 60 | 2.88 | 0 | 100 | 40 | 66.66666667%
 |  |  | 2 | Widerstand | 470R | 0805 | Mouser | 652-CR0805JW-471ELF | https://www.mouser.ch/ProductDetail/Bourns/CR0805-JW-471ELF | 0.011 | 0.02 | 120 | 1.32 | 30 | 200 | 110 | 91.66666667%
 |  |  | 2 | Widerstand | 5k1R | 0805 | Mouser | 755-SFR10EZPF5101 | https://www.mouser.ch/ProductDetail/ROHM-Semiconductor/SFR10EZPF5101?qs=PqoDHHvF6491bPJygeZFGw%3D%3D | 0.132 | 0.26 | 120 | 15.84 | 0 | 200 | 80 | 66.66666667%
 |  |  | 0.5 | LCD 4x40 Zeichen | EADIP203-4 |  | Reichelt | EA DIP203G-4 | https://www.reichelt.de/ch/de/lcd-dip-modul-supertwist-4x20-zeichen-gb-gn-ea-dip203g-4-p129611.html?nbc=1 | 32.830 | 16.41 | 30 | 984.90 | 21 |  | -9 | -30%
 |  |  |  |  |  |  |  |  |  |  |  |  |  |  |  | #VALUE! | #VALUE!
 |  |  |  |  |  |  |  |  |  |  |  |  |  |  |  | #VALUE! | #VALUE!
 |  |  |  |  |  |  |  |  |  |  |  |  |  |  |  | #VALUE! | #VALUE!
 |  |  |  |  |  |  |  |  |  |  |  |  |  |  |  | #VALUE! | #VALUE!
 |  |  |  |  |  |  |  |  |  |  |  |  |  |  |  | #VALUE! | #VALUE!
 |  |  |  |  |  |  |  |  |  |  |  |  |  |  |  | #VALUE! | #VALUE!
 |  |  |  |  |  |  |  |  |  |  |  |  |  |  |  | #VALUE! | #VALUE!
 |  |  |  |  |  |  |  |  |  |  |  |  |  |  |  | #VALUE! | #VALUE!
 |  |  |  |  |  |  |  |  |  |  |  |  |  |  |  | #VALUE! | #VALUE!
 |  |  |  |  |  |  |  |  |  |  |  |  |  |  |  | #VALUE! | #VALUE!
 |  |  |  |  |  |  |  |  |  |  |  |  |  |  |  | #VALUE! | #VALUE!
 |  |  |  |  |  |  |  |  |  |  |  |  |  |  |  | #VALUE! | #VALUE!
 |  |  |  |  |  |  |  |  |  |  |  |  |  |  |  | #VALUE! | #VALUE!
 |  |  |  |  |  |  |  |  |  |  |  |  |  |  |  | #VALUE! | #VALUE!
 |  |  |  |  |  |  |  |  |  |  |  |  |  |  |  | #VALUE! | #VALUE!
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
 |  |  |  |  |  |  |  |  |  |  |  |  |  |  |  |  | #VALUE!
 |  |  |  |  |  |  |  |  |  |  |  |  |  |  |  |  | #VALUE!
 |  |  |  |  |  |  |  |  |  |  |  |  |  |  |  |  | #VALUE!
 |  |  |  |  |  |  |  |  |  |  |  |  |  |  |  |  | #VALUE!
 |  |  |  |  |  |  |  |  |  |  |  |  |  |  |  |  | #VALUE!
 |  |  |  |  |  |  |  |  |  |  |  |  |  |  |  |  | #VALUE!

Sheet: Anzahl & Preis
Anzahl Boards: | 60
Preis ein Board: | 103.43
Preis 60 Boards: | 6205.87

Sheet: Altes
Bemerkung | Pos | Bezug | Stk/Board | Bezeichnung | Typ/Wert | Gehäuse | Lieferant | Artikel-Nr | Link | Preis/Stk | Preis/Board | Stk für 60 | Preis für 60 | Status (ok)
nicht bestellen |  |  | 0 | Sicherung | MC12CT 002 / 2,0A | 1206 | Farnell | 1841062 |  | 0.226 |  | 0
nicht bestellen |  |  | 0 | 9P Header für LCD Display | 1x9 Pin SMD | 2mm | Mouser | 517-953109-2000-AR-PR |  | 2.510 |  | 0
Nicht bestücken |  |  | 0 | MICRO USB 2.0 BUCHSE | MOLEX 47589-0001 | TYP AB | Farnell | 1568023 |  | 0.662 |  | 0
nicht bestellen |  |  | 0 | Speisgerät 5V Micro USB | 5V / 2.5A 1.5m Kabel |  | Farnell | 2520785 |  | 9.330 |  | 0
nicht bestücken |  |  | 0 | DIP Switch 8x, 21.2x6.2 | 8 fach DIP Switch, 2.54mm | DIP-16 | Mouser | 642-DMR08T |  | 1.020 |  | 0
nicht bestellen |  |  | 0 | JTAG Stiftwanne | 10pol. 2x5 pin | 1.27mm | Mouser | 855-M50-3500542 |  | 0.895 |  | 0
nicht Bestellen |  |  | 0 | XY Joystick |  |  |  |  | www.parallax.com/product/27800 | 6.500 |  | 0
nicht Bestellen |  |  | 0 | LED | red | 1206 | Mouser | 604-APT3216SRCPRV |  | 0.075 |  | 0
nicht Bestellen |  |  | 0 | Schieberegister |  | So-16 | Mouser | 771-HC165D652 |  | 0.194 |  | 0
nicht Bestellen |  |  | 0 | Weisse LED | 150mcd, 3.3V, 20mA | 1206 | Distrelec | 634021 |  | 0.368 |  | 0
nicht Bestellen |  |  | 0 | DC/DCKonverter 5VDC 1A, Traco Power | TSR 1-2450 |  | Distrelec | 361662 |  | 5.500 |  | 0
- |  |  | 1 | Quarz | 16MHz | HC49 | Mouser | 520-CSM1600-20-X |  | 0.295 | 0.29 | 60 | 17.70
- |  |  | 3 | Elektrolytkondensator | 100uF 35V | 6.3 x 5.4 | Mouser | 647-UWT1V101MCL1S |  | 0.125 | 0.38 | 180 | 22.50 | 20, 150 bestellt
- |  |  | 20 | Widerstand | 150Ω | 1206 | Mouser | 71-CRCW1206150RFKEB |  | 0.010 | 0.20 | 1200 | 12.00
- |  |  | 1 | Lichtsensor | ALS-PT17-51C/L177/TR8 |  | Distrelec | 632917 |  | 0.879 | 0.88 | 60 | 52.74 | 20, 50 bestellt
- |  |  | 4 | FET N-Kanal 30V, 7.6A, 17mΩ | PMV20EN | SOT-23 | Mouser | 771-PMV20ENR |  | 0.108 | 0.43 | 240 | 25.92
- |  |  | 1 | Mikrocontroller | ATMEGA2560-16AU | TQFP-100 | Mouser | 556-ATMEGA2560-16AU |  | 16.570 | 16.57 | 60 | 994.20
- |  |  | 1 | Schmitt_Tirgger | Logic-IC SO-14, 74HC14D, NXP | SO-14 | Distrelec | 17390099 |  | 0.320 | 0.32 | 60 | 19.20 | 10, 50 bestellt
- |  |  | 1 | Potentiometer | 3314G-1-503E / 50k | 3314G | Mouser | 652-3314G-1-503E |  | 1.620 | 1.62 | 60 | 97.20 | 20, 50 bestellt
 |  |  | 1 | LED | RGB | PLCC6 | Mouser | 941-X6AFKBCJNNRFJ7A3 |  | 0.364 | 0.36 | 60 | 21.84 |  | 56
 |  |  | 1 | Temperatursensor LM35DZ | TO-92 | 1,27mm | Mouser | 926-LM35DZ/NOPB |  | 0.749 | 0.75 | 60 | 44.94 | XXXXXXXXXXXXXXXXX | 18
 |  |  | 20 | FET N-Kanal 30V, 7.6A, 17mΩ | PMV20EN | SOT-23 | Mouser | 621-DMG3406L-13 |  | 0.088 | 1.76 | 1200 | 105.60 | XXXXXXXXXXXXXXXXX | 0 Box Fehlt
 |  |  | 1 | Spannungsregler 3.3V | XC6220B331MR-G | SOT-25 | Farnell | 1830935 |  | 0.782 | 0.78 | 60 | 46.92 | 40 Bestellt | 4
 |  |  | 0.5 | LCD 4x40 Zeichen | EADIP203-4 |  | Mouser | 790-EADIP203J-4NLW |  | 32.830 | 16.41 | 30 | 984.90 | 8
 |  |  | 2 | 9P Header für LCD Display | 1x9 Pin SMD | 2mm | Mouser | 200-MMS10902FSV |  | 2.100 | 4.20 | 120 | 252.00 | 20
 |  |  | 2 | Widerstand | 2kΩ | 1206 | Mouser | 71-CRCW12062K00FKEB |  | 0.031 | 0.06 | 120 | 3.72 | 0
 |  |  | 3 | Keramikkondensator | 1uF 50V | 1206 | Mouser | 77-VJ1206V105MXATBC |  | 0.040 | 0.12 | 180 | 7.20 | 10
 |  |  | 20 | Widerstand | 150Ω | 1206 | Mouser | 652-CR1206FX-1500ELF |  | 0.011 | 0.22 | 1200 | 13.20 | 100 | 1500 | 400
 |  |  | 1 | Lichtsensor | SFH 5701 |  | Mouser | 720-SFH5701 |  | 0.615 | 0.61 | 60 | 36.90 |  |  | -60 | -100%
 |  |  | 1 | 2x7 Stiftwanne 2514 | 3M | 2,54mm | Mouser | 517-30314-6002 |  | 1.210 | 1.21 | 60 | 72.60 | 50 |  | -10 | -16.66666667%
 |  |  | 15 | Keramikkondensator | 100nF 50V | 1206 | Mouser | 77-VJ1206V104ZXAPBC |  | 0.017 | 0.26 | 900 | 15.30 | 200 |  | -700 | -77.77777778%

Sheet: Halbleiterbezug
Stk/Board | Bezeichnung | Typ/Wert | Name 1 | Name 2 | Name 3 | Name 4 | Name 5 | Name 6 | Name 7 | Name 8 | Name 9 | Name 10 | Name 11 | Name 12 | Name 13 | Name 14 | Name 15 | Name 16 | Name 17 | Name 18
1 | Schmitt_Tirgger | Logic-IC SO-14, 74HC14D, NXP
1 | Mikrocontroller | ATMEGA2560-16AU
1 | 74HC138 3 to 8 Decoder | Texas
1 | Quarz | 16MHz
1 | LCD 4x40 Zeichen | EADIP203-4
1 | Lichtsensor | SFH 5701
1 | Spannungsregler 3.3V | XC6220B331MR-G
1 | LED | Grün
1 | Quarz | 32.768kHz
1 | Temperatursensor LM35DZ | TO-92
1 | LED | RGB
2 | Hallsensor SS39E | Honeywell
20 | FET N-Kanal 30V, 7.6A, 17mΩ | PMV20EN
8 | FET P-Kanal 20V, 5.6A, 27mΩ | PMV27UPER
16 | LED | Blau
1 | PCB
58 | Total |  | 0 | 0 | 0 | 0 | 0 | 0 | 0 | 0 | 0 | 0 | 0 | 0 | 0 | 0 | 0 | 0 | 0 | 0
Zeit Board 1
Zeit Board 1
Zeit Board 1 | Total |  | 0 | 0 | 0 | 0 | 0 | 0 | 0 | 0 | 0 | 0 | 0 | 0 | 0 | 0 | 0 | 0 | 0 | 0
Zeit Board 2
Zeit Board 2
Zeit Board 2 | Total |  | 0 | 0 | 0 | 0 | 0 | 0 | 0 | 0 | 0 | 0 | 0 | 0 | 0 | 0 | 0 | 0 | 0 | 0
