msw-winterthur/uC_Board/(list of files, cad)

Other CAD files:
Hardware/Vorlage ATmega2560-16AU/Vorlage uCBoard.f3z
Hardware/Vorlage ATmega2560-16AU/Vorlage+uCBoard.f3z
