msw-winterthur/uC_Board/Dokumente/Hardwarestruktur und Testprotokoll.xlsx

Sheet: Hardwarekonzept
Hardwarestruktur |  |  |  | Datum:
Projekt: |  |  |  | Mikrocontroller:
Autor Name: |  |  |  | Autor Vorname:
Kandidaten-Nr.:
Eingänge Schalter |  |  |  |  | Port:
Bit | Konfig | Hardware | Signalbeschreibung | Codebezeichner (Variabelname) | Name | Bit
0 | digital | S5 |  |  |  | 0
1 | digital | S6 |  |  |  | 1
2 | digital | S7 |  |  |  | 2
3 | digital | S8 |  |  |  | 3
4 | digital | S9 |  |  |  | 4
5 | digital | S10 |  |  |  | 5
6 | digital | S11 |  |  |  | 6
7 | digital | S12 |  |  |  | 7
Eingänge Taster (mittels Hardware entprellt) |  |  |  |  | Port:
Bit | Konfig | Hardware | Signalbeschreibung | Codebezeichner (Variabelname) | Name | Bit
0 | digital | S1 |  |  |  | 0
1 | digital | S2 |  |  |  | 1
6 | digital | S3 |  |  |  | 6
7 | digital | S4 |  |  |  | 7
Ausgänge LEDs |  |  |  |  | Port:
Bit | Konfig | Hardware | Signalbeschreibung | Codebezeichner (Variabelname) | Name | Bit
0 | digital | H0 |  |  |  | 0
1 | digital | H1 |  |  |  | 1
2 | digital | H2 |  |  |  | 2
3 | digital | H3 |  |  |  | 3
4 | digital | H4 |  |  |  | 4
5 | digital | H5 |  |  |  | 5
6 | digital | H6 |  |  |  | 6
7 | digital | H7 |  |  |  | 7
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
