msw-winterthur/uC_Board/(threads)

Thread 10 (2021-11-05):

PG1 PG0 auf JTAG?

DarioMSW, 2021-11-05:
Müssen PG1 und PG0 (LCD) auf den JTAG? Probleme mit PG1 auf JTAG Pin 8 --> kann verwendet werden um ICE-Box zurückzusetzen....
https://microchipdeveloper.com/atmelice:connecting-atmel-ice-to-a-jtag-target

Thread 13 (2023-10-06):

USB-C Speisung

TheguyfromWallisellen, 2023-10-06:
Das uC-Board kann nur mit einem "Dummen" PSU betrieben werden. Es währe nicht schlecht, wenn wir die CC Pins mit einem Pull-Down Widerstand verbinden würden. So könnte man mit einem "schlauen" PSU das uC-Board speisen.

--> Hier noch der link zum USB-C Stecker, wo alles nochmals beschrieben wird.
https://www.allaboutcircuits.com/technical-articles/introduction-to-usb-type-c-which-pins-power-delivery-data-transfer/

DarioMSW, 2023-10-09:
Hallo und vielen Dank für deinen Beitrag!

Wenn ich den Beitrag richtig verstehe, soll CC1 und CC2 je mit einem PullDown versehen werden. Wie gross sollen die PullDowns sein?

Gruss

TheguyfromWallisellen, 2023-10-09:
Ich habe im Internet nachgeschaut und habe gefunden, dass ich einen 5.1k widerstand nehmen sollte. Ich habe es ausprobiert und bin zum schluss gekommen, dass es auch funktioniert. Mit 10k (wie wir es im Unterricht angeschaut haben) hatte ich nicht so glück. Es funktionierte nicht.

Im Bild habe ich nur einen Pulldown-Resistor drin. Es währe jedoch wichtig, dass man dann im Layout auch den zweiten CC-Pin runterziehen muss, da es sonst nur funktionieren würde, wenn das Kabel gerade richtig eingesteckt ist. Ausserdem sollten die beiden CC-Pins nicht kurzgeschlossen und dann auf GND gezogen werden, sondern beide separat heruntergezogen werden.

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

DarioMSW, 2023-10-27:
Wir brauchen 5V, 2A

Hätte ein Bauteil wie der HUSB238 einen Vorteil gegenüber der Lösung mit Widerständen?
https://en.hynetek.com/2421.html

TheguyfromWallisellen, 2023-10-30:
Hoi Dario,

Ich da hat sich wohl ein Fehler eingeschlichen.

So wie ich es verstanden habe, sollte es möglich sein, damit 3A zu ziehen. Jedoch währe es nicht schlecht, wenn du dir noch das PDF anschaust, damit wir beide sicher sind.

Wenn du möchtest, kann ich auch diese Schaltung noch diese Woche Testen und dir die Resultate dokumentiert zusenden.

Deine Lösung ist auch gut, da aber unser Board nur 5v 3A brauchen kann währe es nicht kosteneffektiv noch einen Zusätzlichen IC zu verwenden.

Ich habe die relevantesten Seiten aus dem PDF kopiert und habe sie dir in den Anhang hochgeladen.

Herzliche Grüsse

***@***.***

Petar Lisinac
Lernender Elektroniker

Zeughausstrasse 56
8400 Winterthur
***@***.******@***.***>
Mobile: +41 76 377 02 53

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

DarioMSW, 2024-05-31:
Closed by d8044bb4e5b6088d9496e6cb1a93cc85671affd4

Closed 2024-05-31.

Thread 16 (2024-07-17):

Led Helligkeit einstellen

Finnja05, 2024-07-17:
Mithilfe eines Potentiometer die Helligkeit der Leds einstellen
Für das 50k Ohm Poti nicht das Poti vom ucBoard nehmen, sondern ein grösseres.
Schema (Schalter ignorieren):
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

DarioMSW, 2024-07-19:
Merci viel mal! Vollständigkeitshalber hier noch die Berechnungen dazu:
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

DarioMSW, 2024-07-19:
Und das ursprüngliche Schema:
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

Quelle: [https://www.allaboutcircuits.com/technical-articles/how-to-design-schmitt-trigger-oscillators/](https://www.allaboutcircuits.com/technical-articles/how-to-design-schmitt-trigger-oscillators/)

DarioMSW, 2024-07-22:
Alles übernommen, sogar für die Power LED. siehe 0665441639059580f35105c3dec4148b134ef4a0

Closed 2024-07-22.
