msw-winterthur/uC_Board/Software/uC_Board/uCBoardVorlage/main.c

/*********************************************************************************\
*
* MMMMMMMMMMMM   SSSSSSSSSSSS   WW   WW   WW   MECHATRONIK
* MM   MM   MM   SS             WW   WW   WW   SCHULE
* MM   MM   MM   SSSSSSSSSSSS   WW   WW   WW   WINTERTHUR
* MM   MM   MM             SS   WW   WW   WW   
* MM   MM   MM   SSSSSSSSSSSS   WWWWWWWWWWWW   www.msw.ch
*
*
* Dateiname: main.c
*
* Projekt  : Muster
* Hardware : uC-Board, ATmega2560v von Atmel
*
* Copyright: MSW, E2
*
* Beschreibung:
* =============
* Siehe Prüfungsaufgabe
*
* Portbelegung:
* =============
* Port C:   Schalter
* Port A:   LEDs
* für genauere Beschreibung siehe Hardwarestruktur
*
* Verlauf:
* ========
* Datum:      Autor:         Version   Grund der Änderung:
* dd.mm.yyyy  M. Muster      V1.0      Neuerstellung
*
\*********************************************************************************/

//uC-Board-Treiber hinzufügen
#include "ucBoardDriver.h"

//Konstanten


//Hauptprogramm
int main(void)
{
    //Variablen
    
    //Initialisieren
    initBoard(0);
    
    //Unendlichschlaufe
    while(1)
    {
        //Eingabe------------------------------------------------------------------
        
        //Verarbeitung-------------------------------------------------------------
        
        //Ausgabe------------------------------------------------------------------
        
    }
}
