msw-winterthur/uC_Board/(commit log)

2020-10-22 Fertiges uC-Board Layout
    [Vorlage ATmega2560-16AU.brd, Vorlage ATmega2560-16AU.sch]
2020-10-22 Gerberfiles von Bestellung hinzugefügt
2020-10-22 Vorlage für Layouttage hinzugefügt
    [Vorlage ATmega2560-16AU.brd, Vorlage ATmega2560-16AU.sch]
2020-10-22 BOM hinzugefügt
    [materialliste_microcontroller_board.xlsx]
2020-10-22 Create Atmega2560 Fuses.png
2020-10-22 Softwarevorlage und HW Test hinzugefügt
2020-10-23 SW Vorlage an board angepasst
2020-10-24 ICE-PCBA und JTag stecker hinzugefügt
    [materialliste_microcontroller_board.xlsx]
2020-10-26 Neuer Treiber und Beispiele
2020-10-26 systime 1ms und writeZahl korrigiert
    [main.c, ucBoardDriver.c, ucBoardDriver.h]
2020-10-26 warnings in driver entfern
2020-10-29 JTAG Stecker korrigiert
    [materialliste_microcontroller_board.xlsx]
2020-10-29 rgb-Test mit buttons
2020-10-30 Treiber aufgeräumt und kommentiert
2020-11-03 Unbenennen von pinInit und PinBsp hinzugefügt
2020-11-03 Hardware aufgeräumt
    [Vorlage ATmega2560-16AU.brd, Vorlage ATmega2560-16AU.sch]
2020-11-04 Micro USB für JTAG hinzugefügt
    [materialliste_microcontroller_board.xlsx]
2020-11-19 ledRead hinzugefügt
2021-02-09 Buttons Schalter und LEDs einzeln ansteuer- und lesbar
2021-06-09 LEDs neu über FET
    [Vorlage ATmega2560-16AU.brd, Vorlage ATmega2560-16AU.sch]
2021-06-09 Sicherung F1 ist 2A
    [Vorlage ATmega2560-16AU.brd, Vorlage ATmega2560-16AU.sch]
2021-06-18 Update für version 2021 (EK20)
    [materialliste_microcontroller_board.xlsx]
2021-06-25 print in uc vorlage
    muss noch in mocca bsp und vorlage und uc vorlage
2021-06-25 lcdLog mit formatted string
    fehlt noch in uc bsp und mocca bsp und vorlage
2021-06-25 formatted text in log und write
    fehlt in bsp und mocca
2021-06-25 uC-Board driver mit Log und formatted write
2021-08-23 PortB an X5 geführt
    PortB ist nun mit LEDs und auf X5 geführt
2021-08-23 Uart auf X5 geführt
    [materialliste_microcontroller_board.xlsx]
2021-08-23 Netzklasse Power ergänzt
    [Vorlage ATmega2560-16AU.brd]
2021-08-25 Lineal hinzugefügt
    [materialliste_microcontroller_board.xlsx]
2021-08-25 Schema neu angeordnet
    [Vorlage ATmega2560-16AU.brd, Vorlage ATmega2560-16AU.sch]
2021-08-25 DRC und ERC zu Checkliste hinzugefügt
2021-08-26 Sensoren ergänzt
2021-08-26 PortK ADC erwähnen...
2021-08-26 Korrektur ADC Erwähnung
2021-08-30 LEDs nicht mehr invertiert weil via FET
2021-09-02 Hardwarestruktur und Programmtestprotokoll hinzugefügt, Dokumente aufgeräumt
    [Programmtest_Protokoll uC-Board.xlsx]
2021-09-09 Neuer Lichtsens und Jtag Buchse
2021-09-09 original fuses added
2021-09-10 Stückzahlen und 50k Trimmer aktualisiert
    [materialliste_microcontroller_board.xlsx]
2021-09-10 Bessere LED-Show
2021-09-17 Bestand in BOM aufgenommen
    [materialliste_microcontroller_board.xlsx]
2021-09-23 neue RGB-LED
    [materialliste_microcontroller_board.xlsx]
2021-09-24 LEDs leuchten beim Aufstarten nicht mehr auf
2021-11-19 Switch active high kann in main gesetzt werden
2021-11-19 Revert "Switch active high kann in main gesetzt werden"
    This reverts commit 727724b0e186165211dfac5a4d8f45e1ea2201e4.
    [main.c, ucBoardDriver.h]
2022-03-24 Netzteil (USB-C) hinzugefügt
    [materialliste_microcontroller_board.xlsx]
2022-08-24 Quarz Q2 richtig verbunden
    [Vorlage ATmega2560-16AU.brd, Vorlage ATmega2560-16AU.sch]
2022-08-25 Alle verwendeten Ports und ADCs hinzugefügt
2022-08-25 Bestand aktualisiert
    [materialliste_microcontroller_board.xlsx]
2022-09-23 Added fuses screenshots doc
2022-12-02 Bestand Materialliste aktualisiert
    [materialliste_microcontroller_board.xlsx]
2023-03-15 Ports und uC entfernt
2023-03-15 Ports entfernt
    [Programmtest_Protokoll uC-Board.xlsx]
2023-06-30 Reaktionszeit in Programmtestprotokoll
    [Programmtest_Protokoll uC-Board.xlsx]
2023-06-30 Hardwarestruktur und Testprotokoll zusammengelegt.
    [Hardwarestruktur und Testprotokoll.xlsx, Programmtest_Protokoll uC-Board.xlsx]
2023-06-30 Update Hardwarestruktur und Testprotokoll.xlsx
    [Hardwarestruktur und Testprotokoll.xlsx]
2023-10-23 CC-Pins hinzugefügt (0805)
    Ich habe beim POWER Block zwei 5.1k Widerstände hinzugefügt. Mit denen sollte es definitiv kein problem sein 250mA zu ziehen.
2023-11-01 Globale interrupts in startsystime
2024-03-25 adcRead keine feste Wartezeit
    Ein Flag in ADC-Read wurde nicht richtig abgewartet, wodurch eine konstante Wartezeit verwendet werden musste. Dies ist korrigiert.
    [MoccaBoardDriver.c, ucBoardDriver.c]
2024-07-19 Bestand aktualisiert von Raul und Ayana EK22
    [materialliste_microcontroller_board.xlsx]
2024-07-22 LED Helligkeit mit einstellbarem PWM
    [Vorlage ATmega2560-16AU.brd, Vorlage ATmega2560-16AU.sch, materialliste_microcontroller_board.xlsx]
2024-07-22 LED Helligkeit mit PWM
2024-07-22 5.1kR Widerstände in BOM und Kommentar in Schema gelöscht
    [Vorlage ATmega2560-16AU.sch, materialliste_microcontroller_board.xlsx]
2024-07-22 Reset button hinzugefügt
    [Vorlage ATmega2560-16AU.brd, Vorlage ATmega2560-16AU.sch, materialliste_microcontroller_board.xlsx]
2024-08-17 Move Eagle-Files in Folder
    [Vorlage ATmega2560-16AU.brd, Vorlage ATmega2560-16AU.sch]
2024-08-17 Add Fusion File
    [Vorlage uCBoard.f3z]
2024-08-17 LED-Helligkeitspoti und ResetButton hinzugefügt
2024-08-21 Netzklassen angepasst
    [Vorlage uCBoard.f3z]
2024-08-22 Checkliste ergänzt / Tipps und Tricks hinzugefügt
2025-09-05 Bestand aktuallisiert
    [materialliste_microcontroller_board.xlsx]
2026-07-17 Neue Positionsnummer und neue Stückliste
